Carriscar1/Iasis-app/hardware/cad/saida/previas/trava_paleta.png

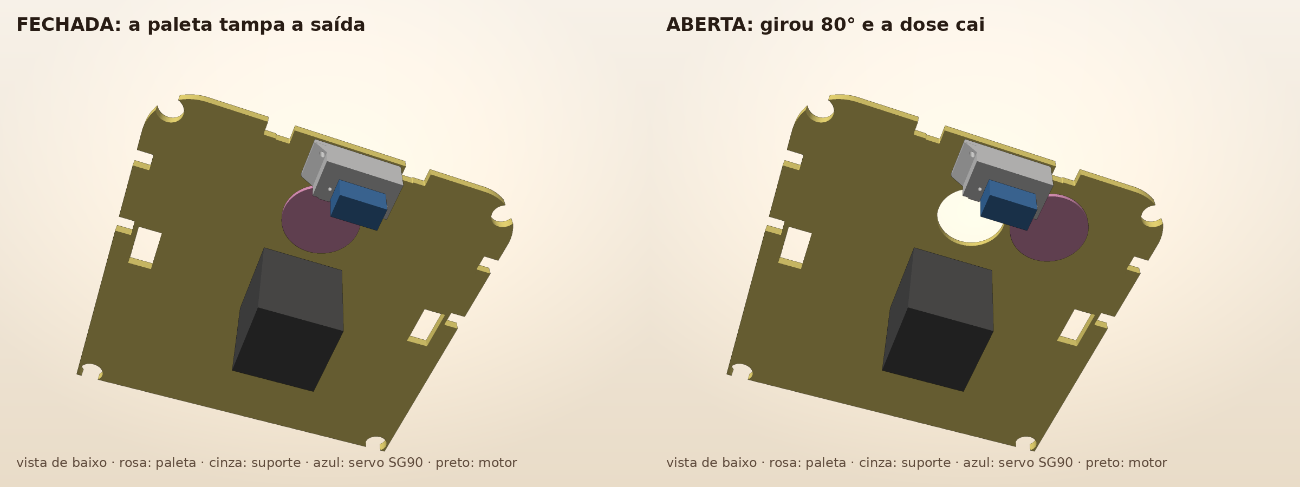
hardware/cad/saida/previas/trava_paleta.png
