Carriscar1/Iasis-app/hardware/cad/saida/previas/trava_calha.png

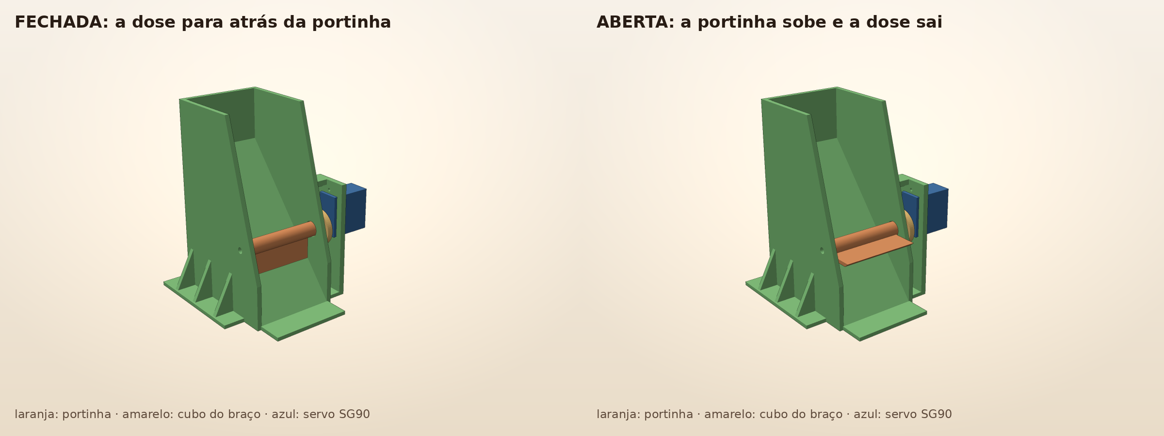
hardware/cad/saida/previas/trava_calha.png
