Carriscar1/Iasis-app/site/public/images/README.md

# 📸 Fotos do produto

Coloque aqui as fotos reais do seu dispenser IASIS. Assim que os arquivos
existirem, o site **troca automaticamente** a ilustração vetorial pela sua foto.

## Nomes dos arquivos (use exatamente estes)

| Arquivo | Onde aparece | Sugestão de foto |
|---|---|---|
| `dispenser.jpg` | Imagem principal (topo da home) | O dispenser inteiro, de frente, fundo claro |
| `detalhe-rfid.jpg` | Galeria "por dentro" | Close do leitor RFID / pulseira sendo aproximada |
| `detalhe-compartimentos.jpg` | Galeria "por dentro" | Close dos compartimentos com comprimidos |
| `detalhe-pulseira.jpg` | Galeria "por dentro" | A pulseira RFID no pulso |

> Aceita `.jpg`, `.jpeg`, `.png`, `.webp` ou `.avif`. Ex: pode ser `dispenser.png`.

## Dicas para a foto ficar profissional

- **Fundo claro e limpo** (uma parede branca ou uma folha grande de papel branco).
- **Boa luz** — de preferência luz natural, perto de uma janela, sem flash direto.
- Enquadre o produto **centralizado**, com um pouco de espaço em volta.
- Proporção ideal da foto principal: parecida com um quadrado ou retrato (ex: 1200×1400).
- As fotos de detalhe ficam melhores em paisagem 4:3 (ex: 1200×900).

Depois de colocar os arquivos aqui, recarregue o site — pronto.
