Carriscar1/Iasis-app/hardware/cad/saida/chaveiro/chaveiro.png

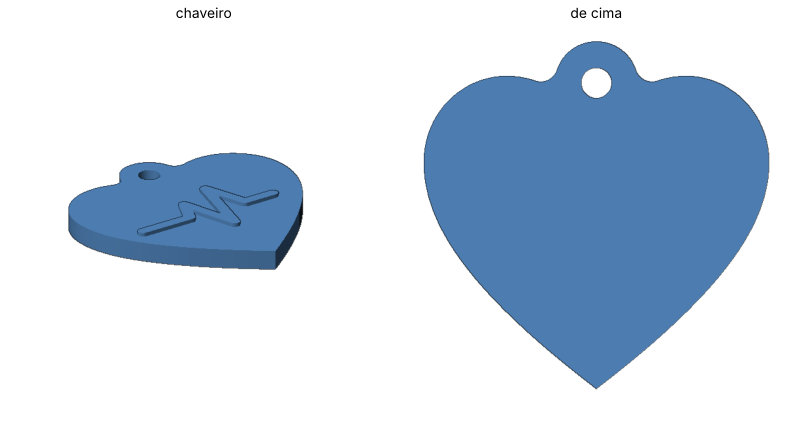
hardware/cad/saida/chaveiro/chaveiro.png
