Carriscar1/Iasis-app/hardware/cad/saida/previas/cortes_encaixes.png

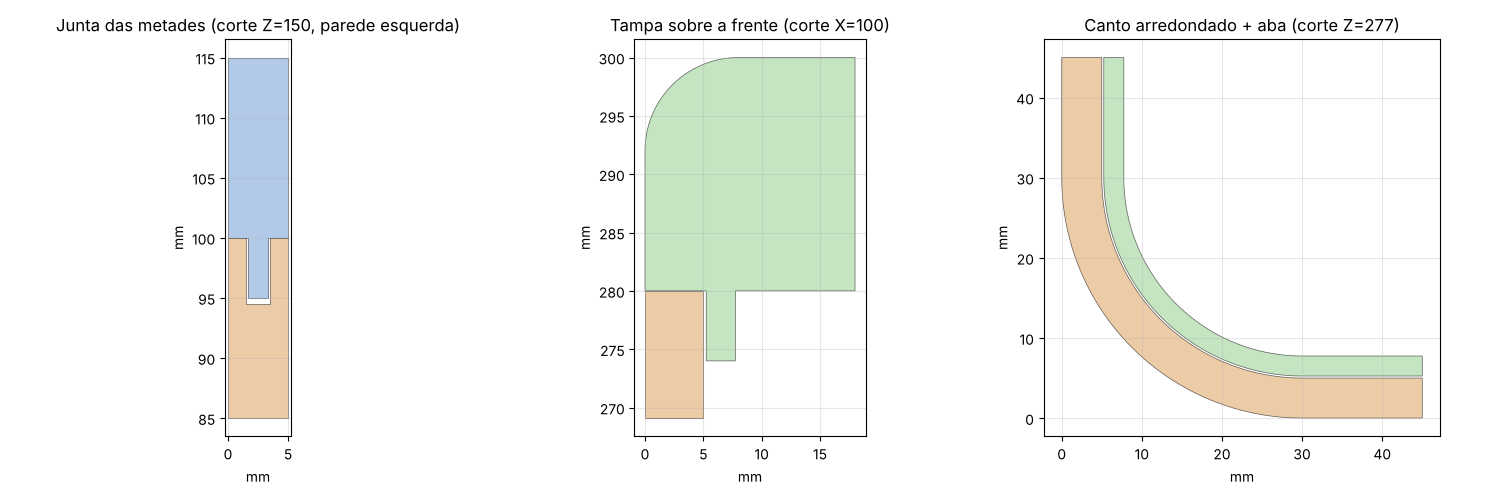
hardware/cad/saida/previas/cortes_encaixes.png
