Carriscar1/Iasis-app/hardware/cad/saida/previas/cortes_folgas.png

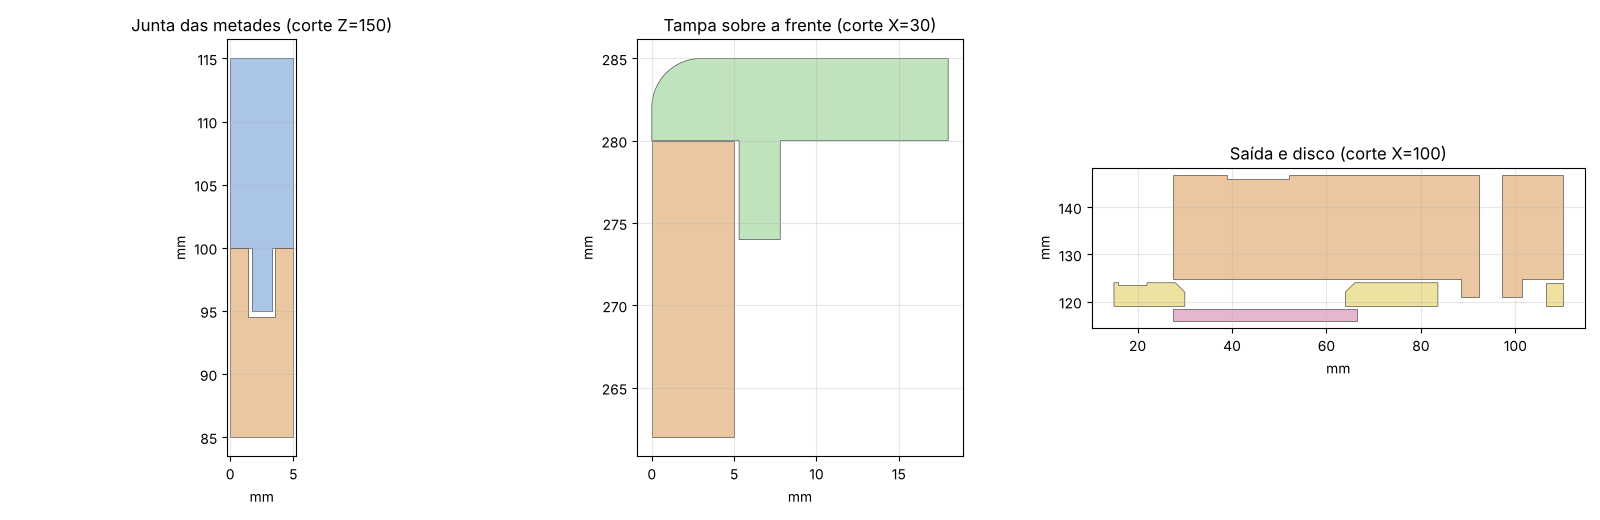
hardware/cad/saida/previas/cortes_folgas.png
