Carriscar1/Iasis-app/hardware/cad/saida/previas/explodida.png

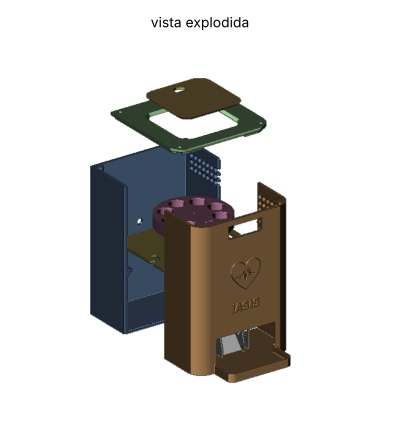
hardware/cad/saida/previas/explodida.png
