Carriscar1/Iasis-app/hardware/cad/saida/previas/frente_junta.png

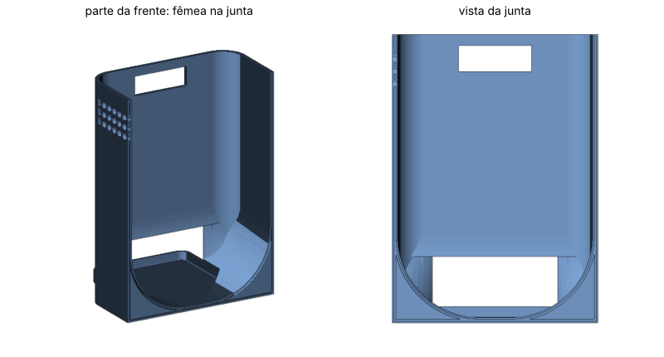
hardware/cad/saida/previas/frente_junta.png
