Carriscar1/Iasis-app/hardware/cad/saida/previas/interior.png

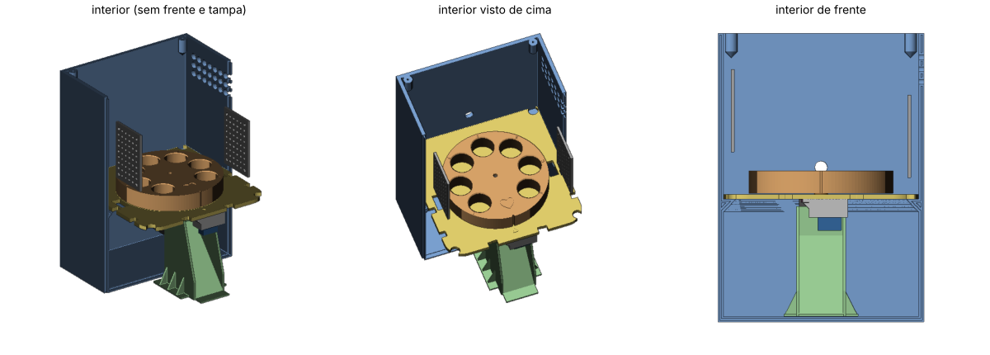
hardware/cad/saida/previas/interior.png
