Carriscar1/Iasis-app/hardware/cad/saida/previas/mecanismo.png

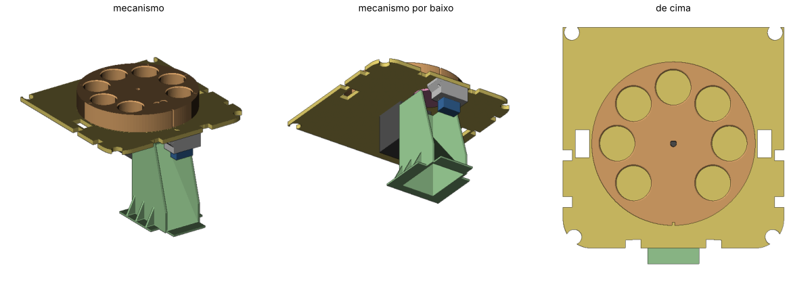
hardware/cad/saida/previas/mecanismo.png
