Carriscar1/Iasis-app/hardware/cad/saida/previas/tampa_aba.png

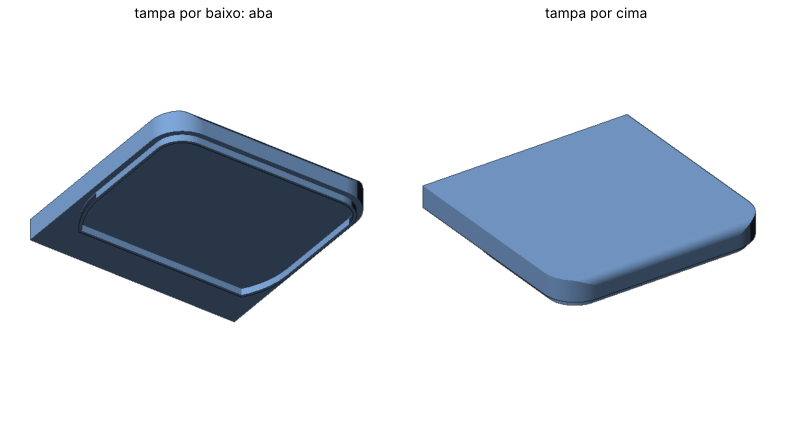
hardware/cad/saida/previas/tampa_aba.png
