Carriscar1/Iasis-app/hardware/cad/saida/previas/tras_junta.png

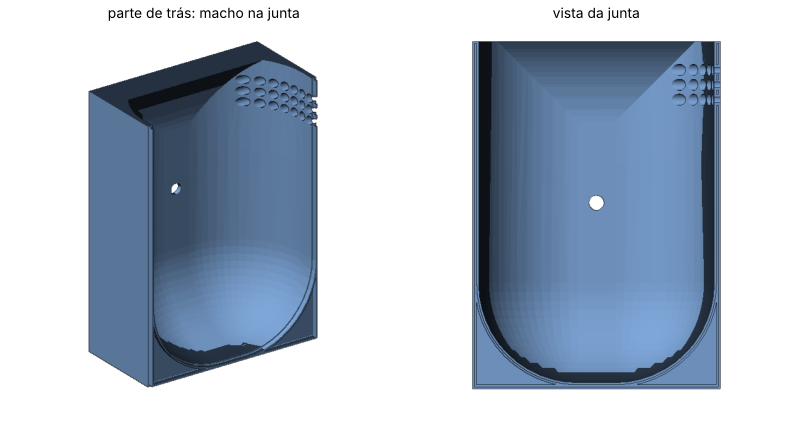
hardware/cad/saida/previas/tras_junta.png
