Carriscar1/Iasis-app/hardware/cad/saida/previas/versao_dividida.png

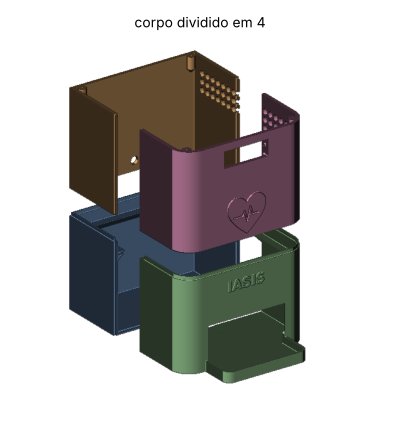
hardware/cad/saida/previas/versao_dividida.png
