Carriscar1/Iasis-app/hardware/cad/originais/peca2_parte_da_frente.stl

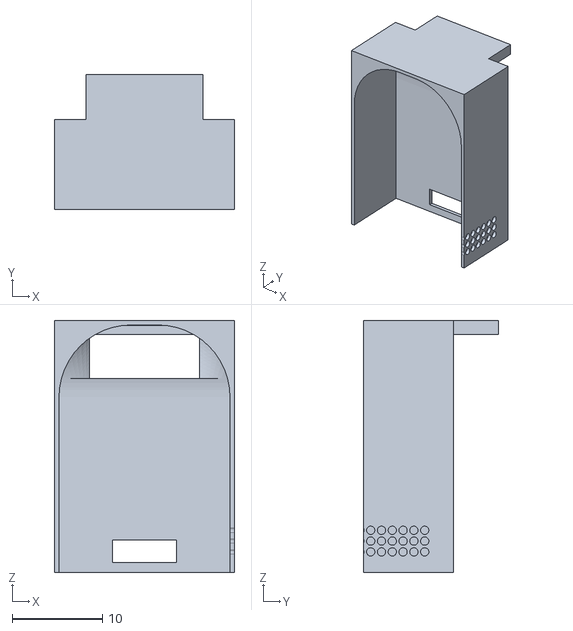
[picture p13: CAD file, 2026-10-19]
hardware/cad/originais/peca2_parte_da_frente.stl
20.0 x 15.0 x 28.0
