Carriscar1/Iasis-app/hardware/cad/saida/chaveiro/chaveiro_base.stl

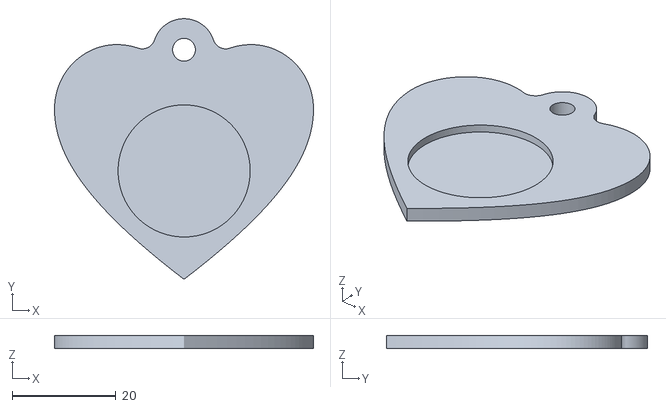
[picture p14: CAD file, 2026-11-05]
hardware/cad/saida/chaveiro/chaveiro_base.stl
50.0 x 50.3 x 2.60
