Carriscar1/Iasis-app/hardware/cad/saida/corpo_de_prova/2_tampa_canto.stl

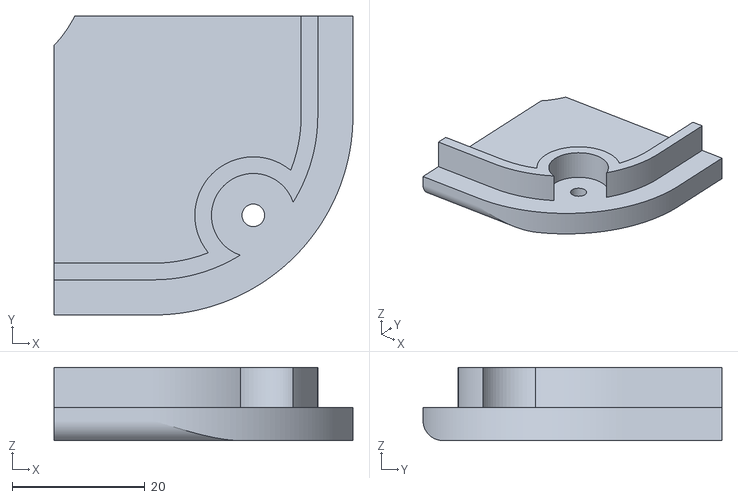
[picture p15: CAD file, 2026-10-21]
hardware/cad/saida/corpo_de_prova/2_tampa_canto.stl
45.0 x 45.0 x 11.0
