Carriscar1/Iasis-app/hardware/cad/saida/imprimir_dividido/gabarito_trava.stl

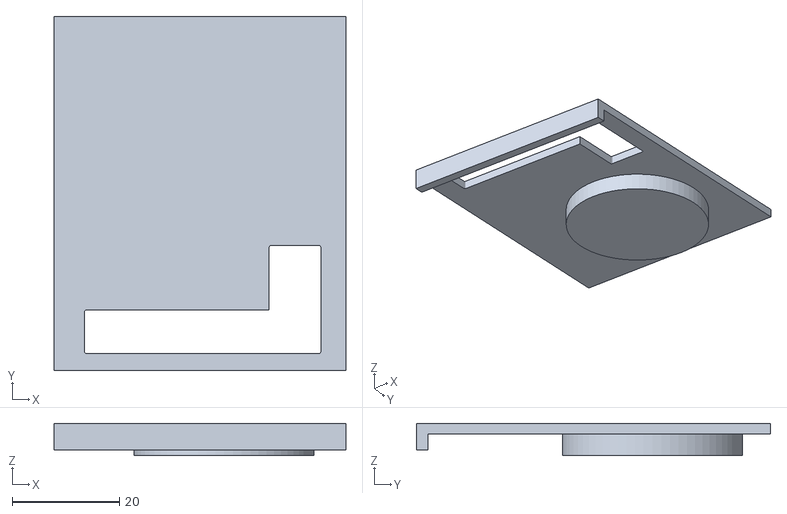
[picture p16: CAD file, 2026-11-10]
hardware/cad/saida/imprimir_dividido/gabarito_trava.stl
54.4 x 66.0 x 6.00
