Carriscar1/Iasis-app/hardware/cad/saida/imprimir_inteiro/paleta.stl

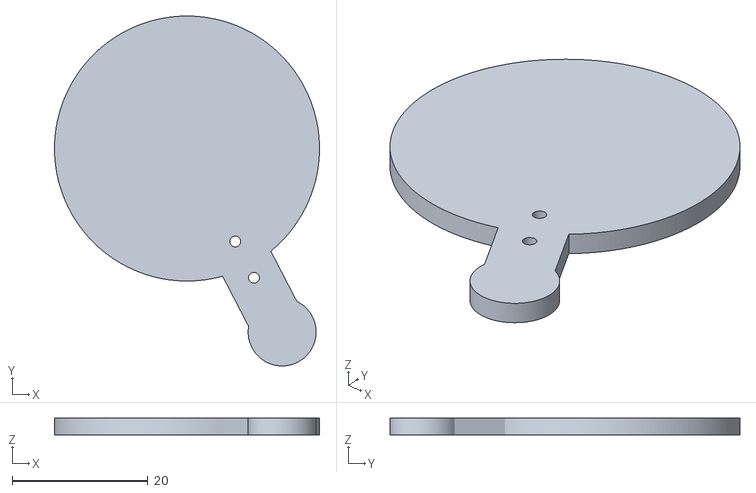
[picture p17: CAD file, 2026-11-10]
hardware/cad/saida/imprimir_inteiro/paleta.stl
39.0 x 51.5 x 2.50
