Carriscar1/Iasis-app/hardware/cad/saida/montagem/suporte_servo.stl

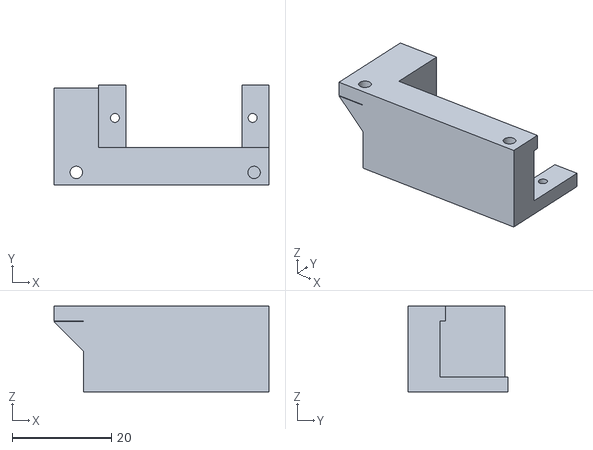
[picture p18: CAD file, 2026-11-10]
hardware/cad/saida/montagem/suporte_servo.stl
43.4 x 20.1 x 17.3
