Carriscar1/Iasis-app/hardware/cad/originais/peca_do_teto.stl

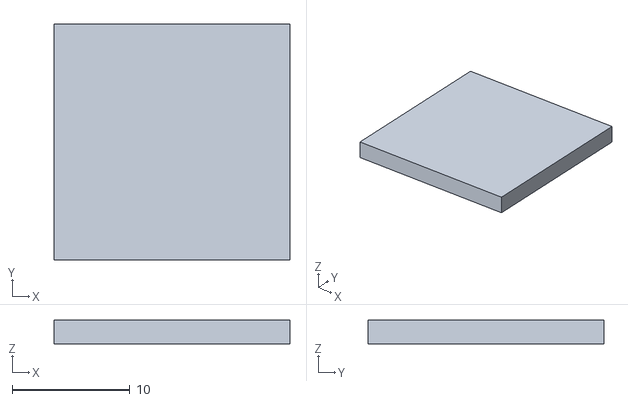
[picture p19: CAD file, 2026-10-19]
hardware/cad/originais/peca_do_teto.stl
20.0 x 20.0 x 2.00
