Carriscar1/Iasis-app/hardware/cad/saida/chaveiro/chaveiro_tampa.stl

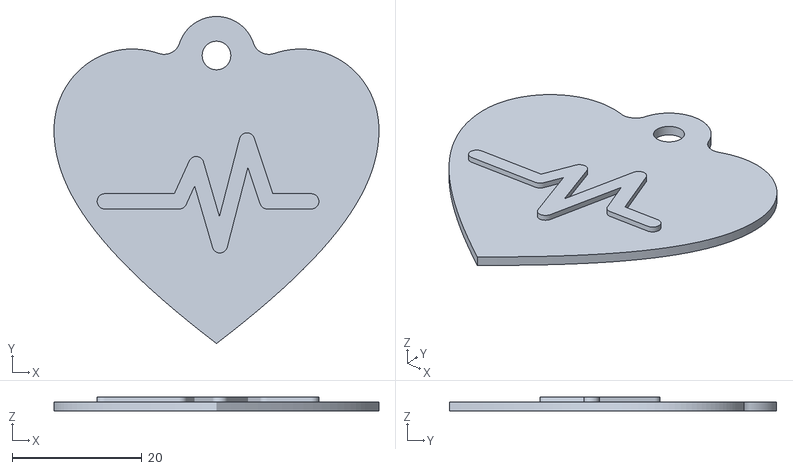
[picture p20: CAD file, 2026-11-05]
hardware/cad/saida/chaveiro/chaveiro_tampa.stl
50.0 x 50.3 x 2.20
