Carriscar1/Iasis-app/hardware/cad/saida/corpo_de_prova/4_disco_centro_no_eixo.stl

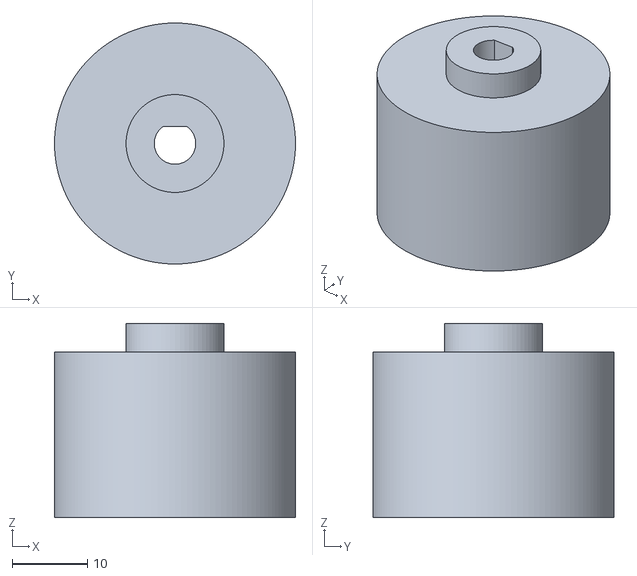
[picture p21: CAD file, 2026-10-21]
hardware/cad/saida/corpo_de_prova/4_disco_centro_no_eixo.stl
32.0 x 32.0 x 25.8
