Carriscar1/Iasis-app/hardware/cad/saida/imprimir_dividido/disco.stl

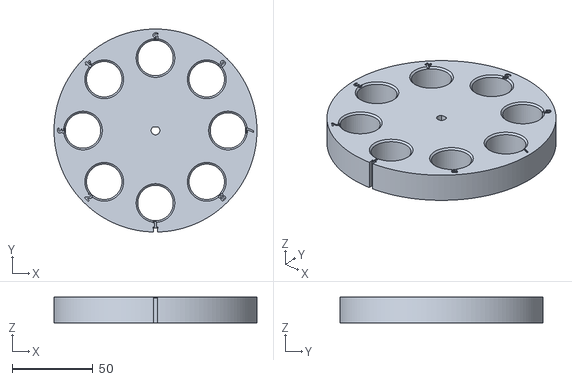
[picture p22: CAD file, 2026-10-20]
hardware/cad/saida/imprimir_dividido/disco.stl
126.0 x 126.0 x 16.0
