Carriscar1/Iasis-app/hardware/cad/saida/montagem/calha.stl

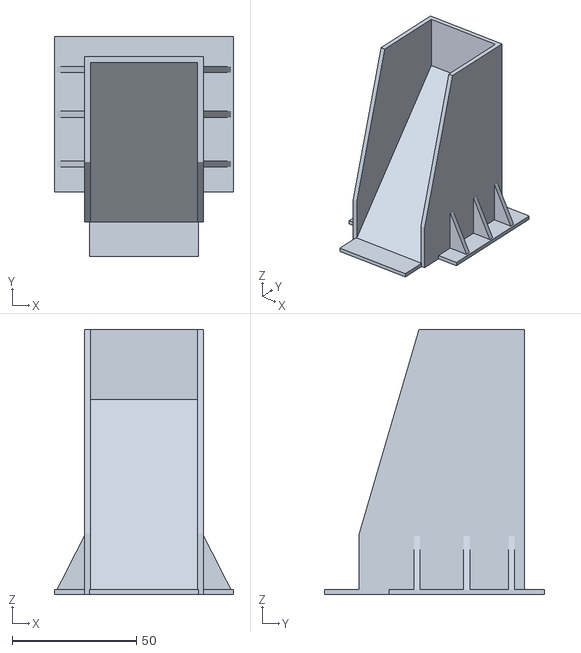
[picture p23: CAD file, 2026-11-10]
hardware/cad/saida/montagem/calha.stl
72.0 x 88.5 x 106.5
