Carriscar1/Iasis-app/hardware/cad/originais/peca1_parte_de_tras.stl

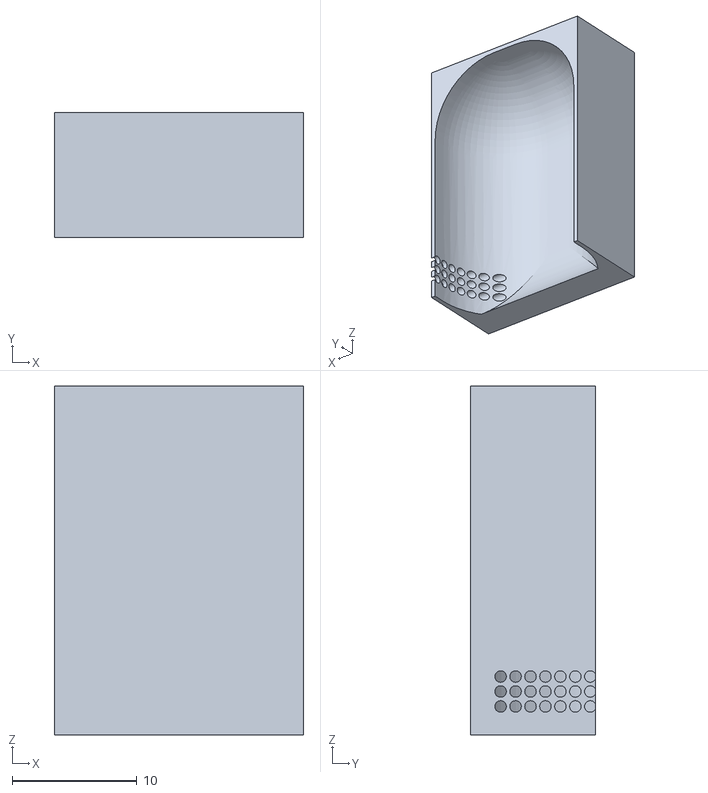
[picture p24: CAD file, 2026-10-19]
hardware/cad/originais/peca1_parte_de_tras.stl
20.0 x 10.0 x 28.0
