Carriscar1/Iasis-app/hardware/cad/saida/chaveiro/chaveiro_com_pausa.stl

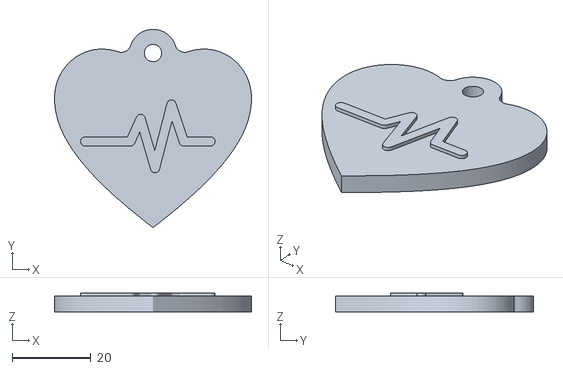
[picture p25: CAD file, 2026-11-05]
hardware/cad/saida/chaveiro/chaveiro_com_pausa.stl
50.0 x 50.3 x 4.80
