Carriscar1/Iasis-app/hardware/cad/saida/corpo_de_prova/5_tampa_portinha_canto.stl

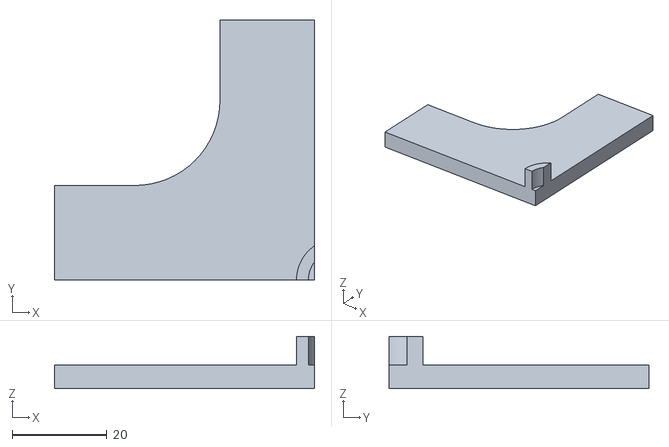
[picture p26: CAD file, 2026-10-21]
hardware/cad/saida/corpo_de_prova/5_tampa_portinha_canto.stl
55.0 x 55.0 x 11.0
