Carriscar1/Iasis-app/hardware/cad/saida/imprimir_dividido/corpo_tras_baixo.stl

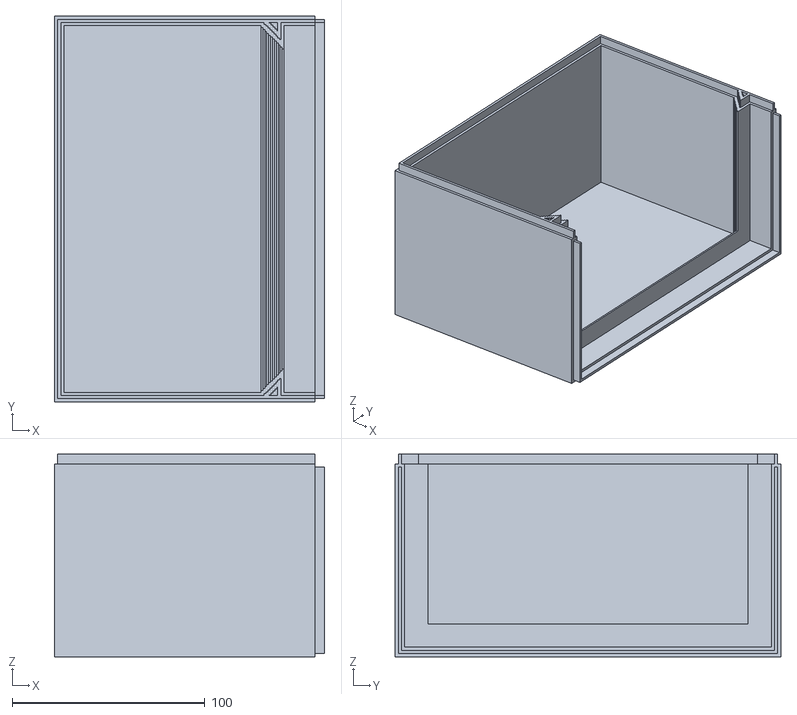
[picture p27: CAD file, 2026-10-20]
hardware/cad/saida/imprimir_dividido/corpo_tras_baixo.stl
140.0 x 200.0 x 105.0
