Carriscar1/Iasis-app/hardware/cad/saida/imprimir_inteiro/cubo_trava.stl

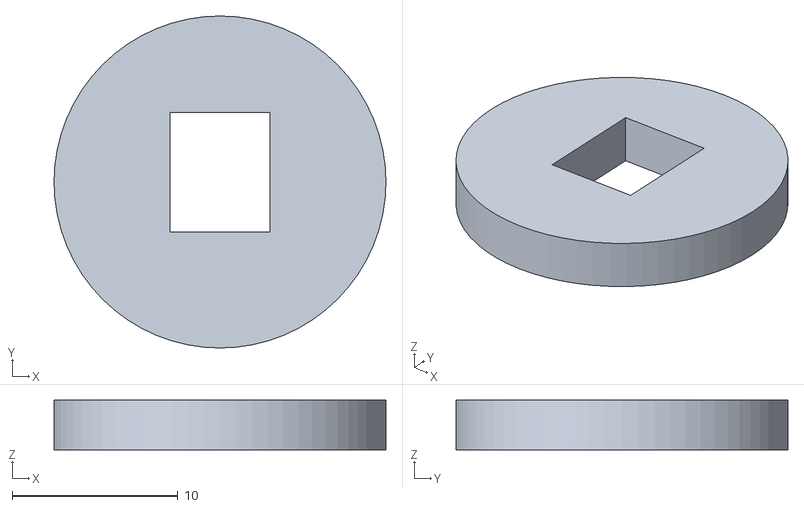
[picture p28: CAD file, 2026-11-05]
hardware/cad/saida/imprimir_inteiro/cubo_trava.stl
20.0 x 20.0 x 3.00
