Carriscar1/Iasis-app/hardware/cad/saida/corpo_de_prova/5_portinha_canto.stl

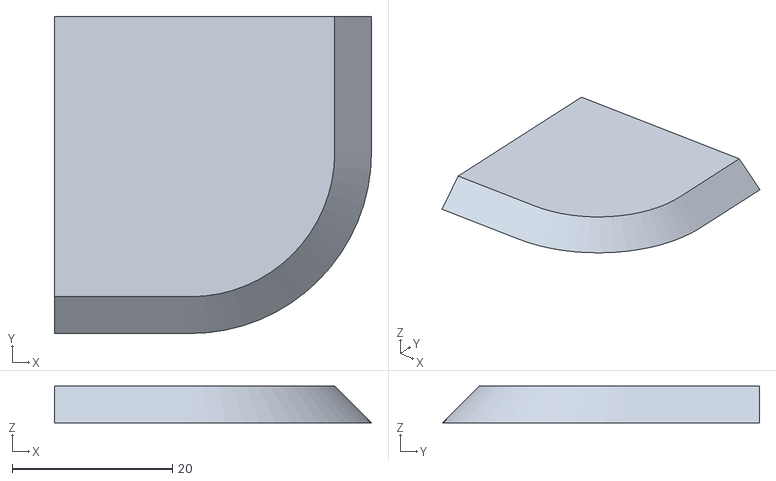
[picture p29: CAD file, 2026-10-21]
hardware/cad/saida/corpo_de_prova/5_portinha_canto.stl
39.6 x 39.6 x 4.60
