Carriscar1/Iasis-app/hardware/cad/saida/imprimir_dividido/corpo_frente_baixo.stl

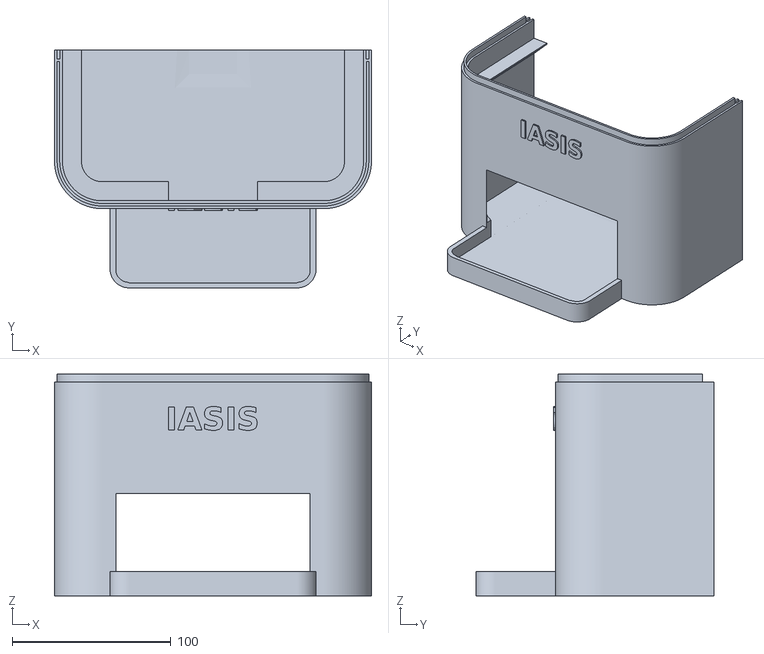
[picture p30: CAD file, 2026-10-20]
hardware/cad/saida/imprimir_dividido/corpo_frente_baixo.stl
200.0 x 150.0 x 140.0
