Carriscar1/Iasis-app/hardware/cad/saida/imprimir_inteiro/calha.stl

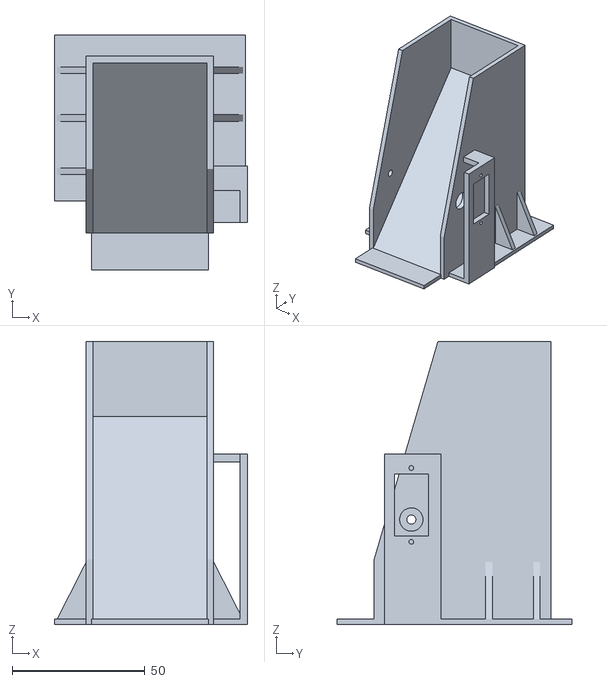
[picture p31: CAD file, 2026-11-05]
hardware/cad/saida/imprimir_inteiro/calha.stl
72.8 x 88.5 x 106.5
