Carriscar1/Iasis-app/hardware/cad/saida/corpo_de_prova/3_divisao_cima.stl

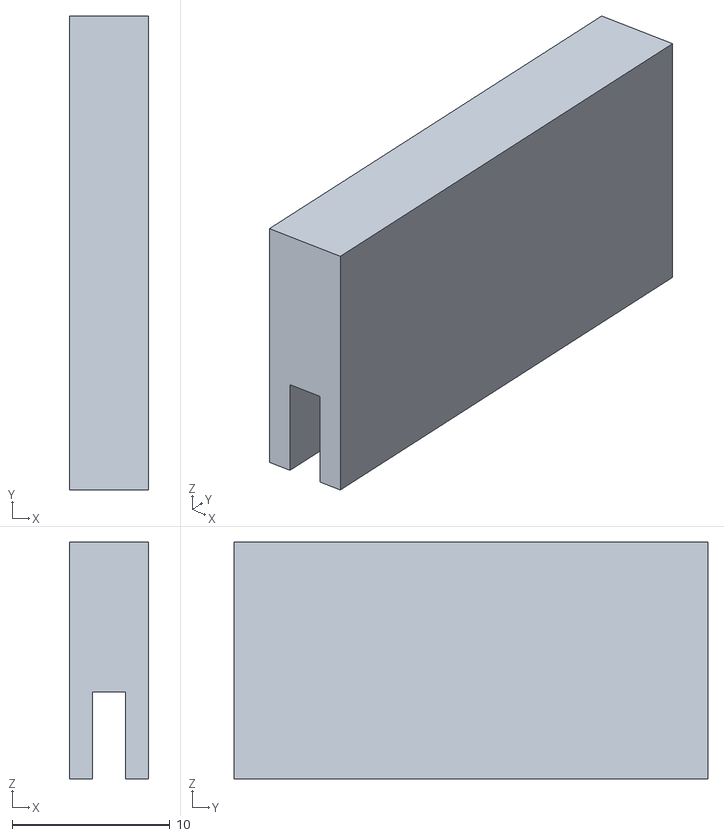
[picture p32: CAD file, 2026-10-20]
hardware/cad/saida/corpo_de_prova/3_divisao_cima.stl
5.00 x 30.0 x 15.0
