Carriscar1/Iasis-app/hardware/cad/saida/imprimir_dividido/corpo_tras_cima.stl

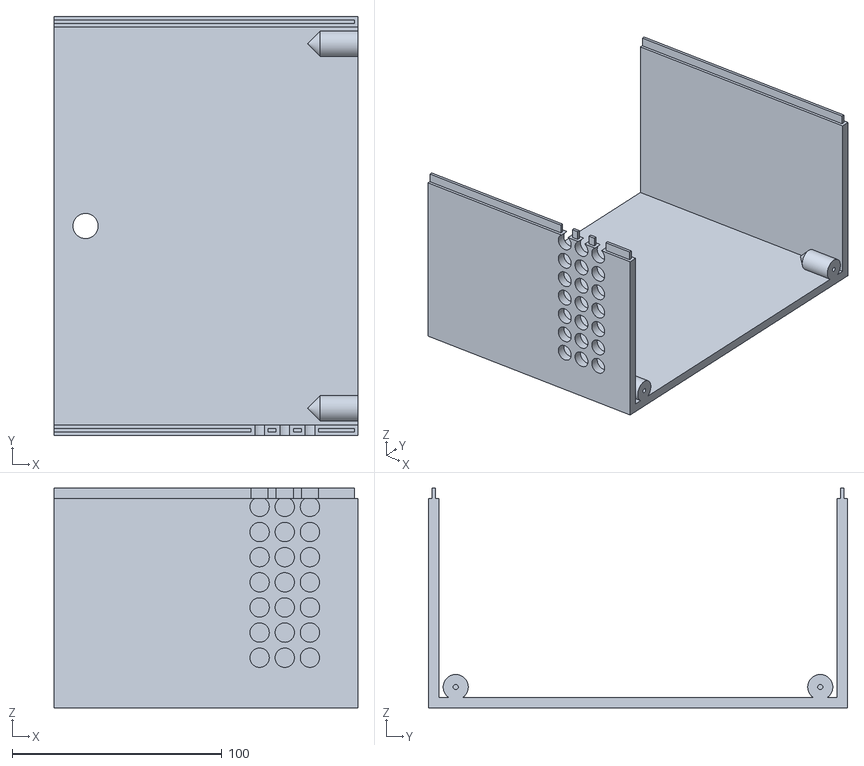
[picture p33: CAD file, 2026-10-20]
hardware/cad/saida/imprimir_dividido/corpo_tras_cima.stl
145.0 x 200.0 x 105.0
