Carriscar1/Iasis-app/hardware/cad/saida/imprimir_inteiro/porta_trava.stl

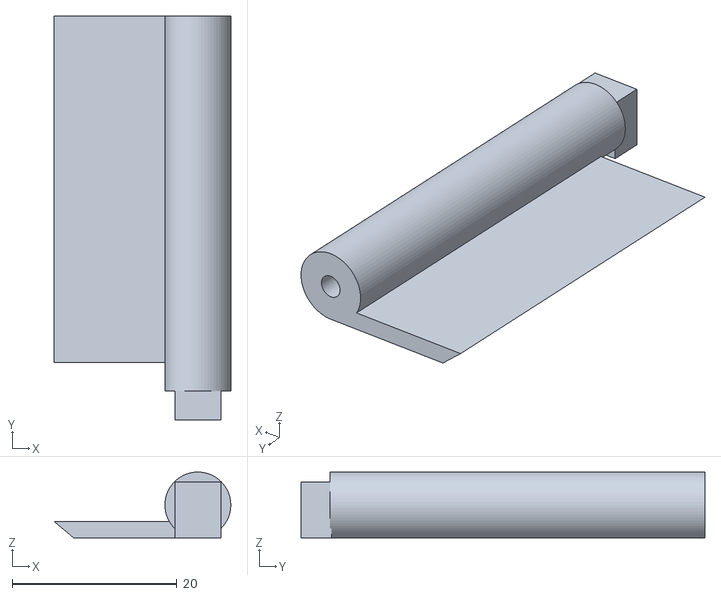
[picture p34: CAD file, 2026-11-05]
hardware/cad/saida/imprimir_inteiro/porta_trava.stl
21.4 x 49.0 x 8.00
