Carriscar1/Iasis-app/hardware/cad/saida/corpo_de_prova/1_junta_parte_da_frente.stl

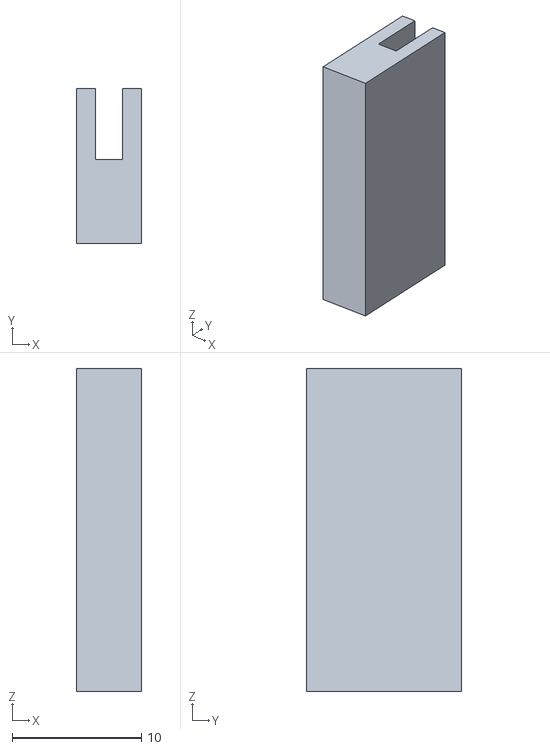
[picture p35: CAD file, 2026-10-20]
hardware/cad/saida/corpo_de_prova/1_junta_parte_da_frente.stl
5.00 x 12.0 x 25.0
