Carriscar1/Iasis-app/hardware/cad/saida/imprimir_dividido/tampa.stl

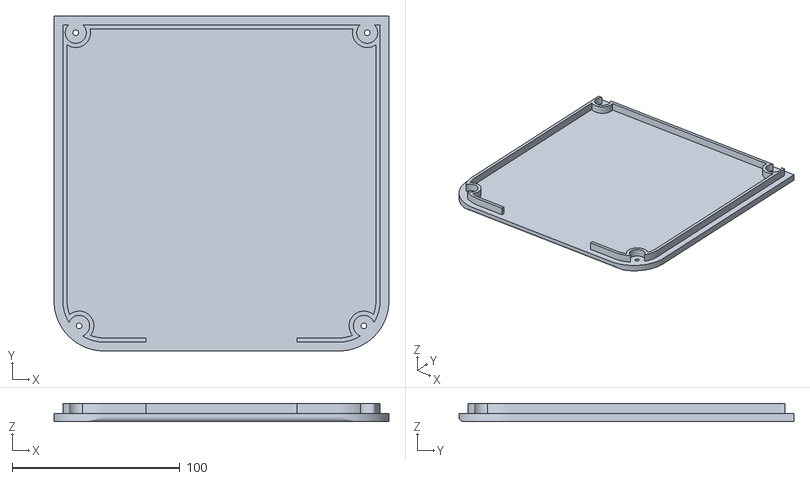
[picture p36: CAD file, 2026-10-20]
hardware/cad/saida/imprimir_dividido/tampa.stl
200.0 x 200.0 x 11.0
