Carriscar1/Iasis-app/hardware/cad/saida/imprimir_inteiro/prateleira.stl

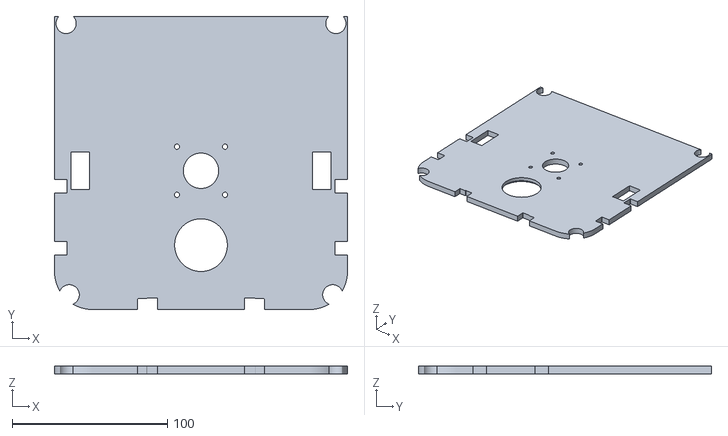
[picture p37: CAD file, 2026-10-21]
hardware/cad/saida/imprimir_inteiro/prateleira.stl
189.0 x 189.0 x 5.00
