Carriscar1/Iasis-app/hardware/cad/saida/corpo_de_prova/3_divisao_baixo.stl

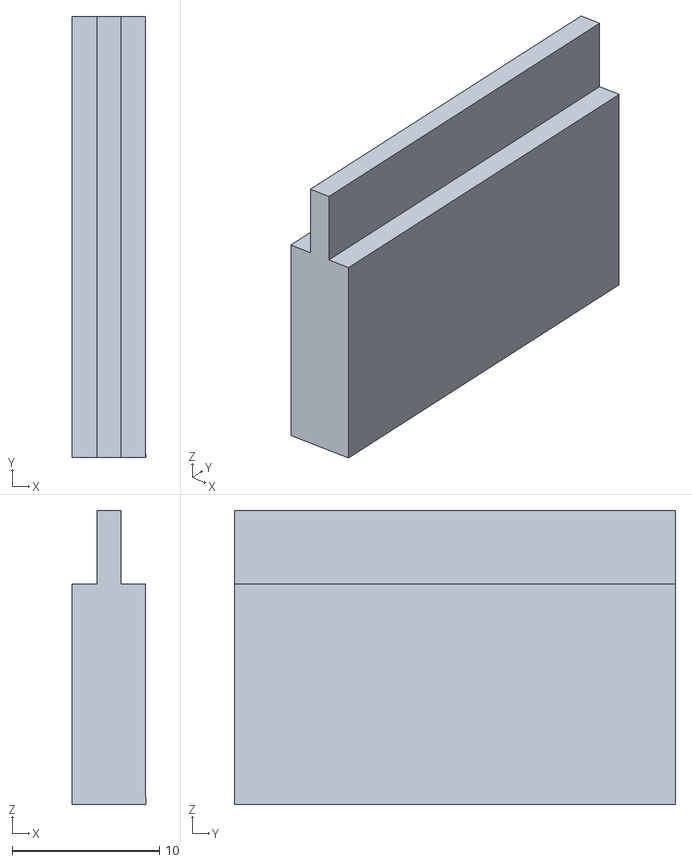
[picture p38: CAD file, 2026-10-20]
hardware/cad/saida/corpo_de_prova/3_divisao_baixo.stl
5.00 x 30.0 x 20.0
