Carriscar1/Iasis-app/hardware/cad/saida/imprimir_dividido/corpo_frente_cima.stl

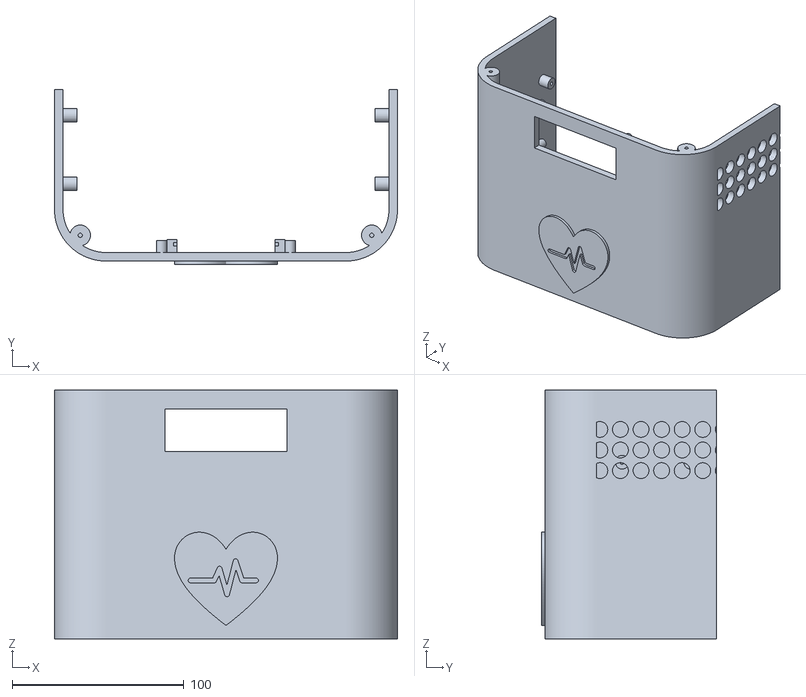
[picture p39: CAD file, 2026-10-20]
hardware/cad/saida/imprimir_dividido/corpo_frente_cima.stl
200.0 x 102.0 x 145.0
