Carriscar1/Iasis-app/hardware/cad/saida/imprimir_inteiro/tampa.stl

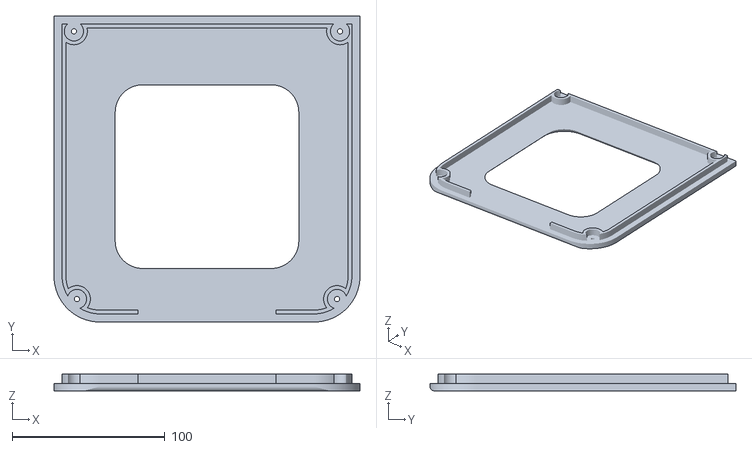
[picture p40: CAD file, 2026-10-21]
hardware/cad/saida/imprimir_inteiro/tampa.stl
200.0 x 200.0 x 11.0
