Carriscar1/Iasis-app/hardware/cad/saida/corpo_de_prova/1_junta_parte_de_tras.stl

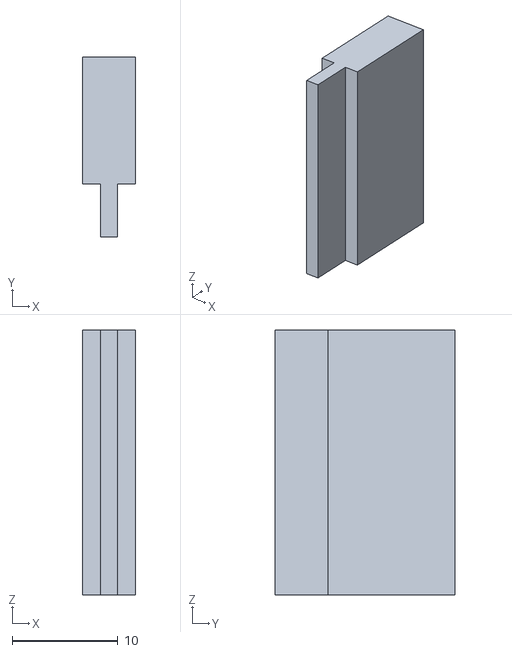
[picture p41: CAD file, 2026-10-20]
hardware/cad/saida/corpo_de_prova/1_junta_parte_de_tras.stl
5.00 x 17.0 x 25.0
