Carriscar1/Iasis-app/hardware/cad/saida/imprimir_dividido/prateleira.stl

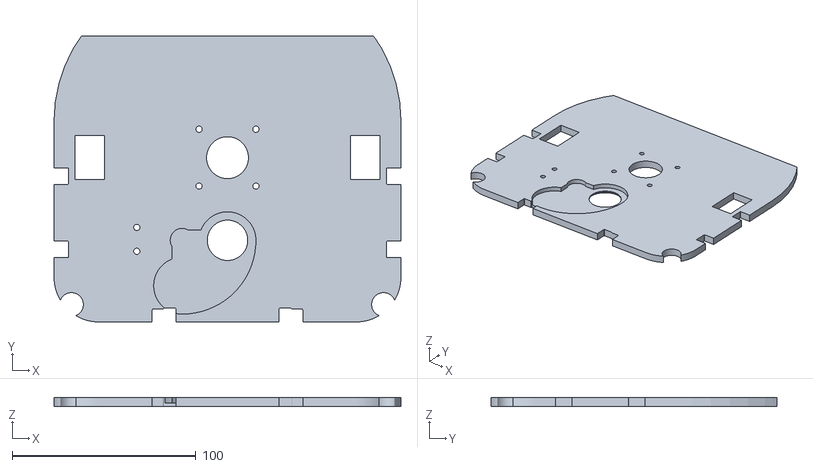
[picture p42: CAD file, 2026-10-20]
hardware/cad/saida/imprimir_dividido/prateleira.stl
189.0 x 155.8 x 5.00
