Carriscar1/Iasis-app/hardware/cad/saida/imprimir_inteiro/disco.stl

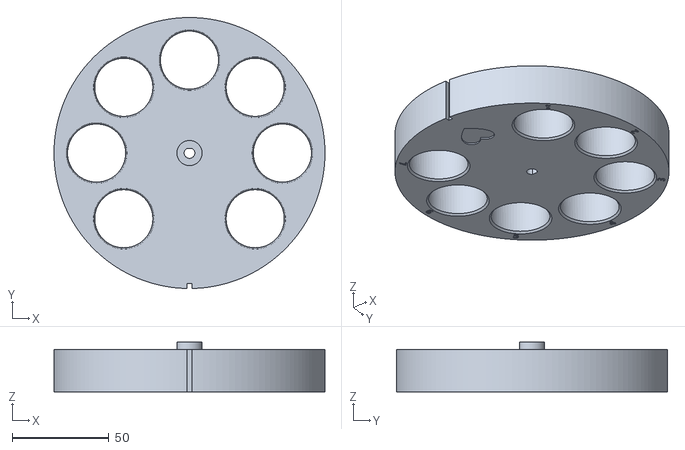
[picture p43: CAD file, 2026-10-21]
hardware/cad/saida/imprimir_inteiro/disco.stl
140.0 x 140.0 x 25.8
