Carriscar1/Iasis-app/hardware/cad/saida/corpo_de_prova/2_corpo_canto_topo.stl

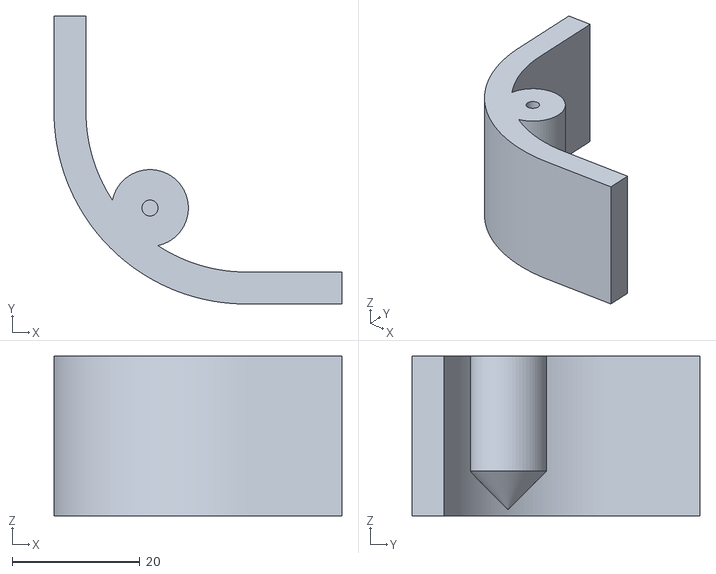
[picture p44: CAD file, 2026-10-20]
hardware/cad/saida/corpo_de_prova/2_corpo_canto_topo.stl
45.0 x 45.0 x 25.0
