Carriscar1/Iasis-app/hardware/cad/saida/imprimir_dividido/calha.stl

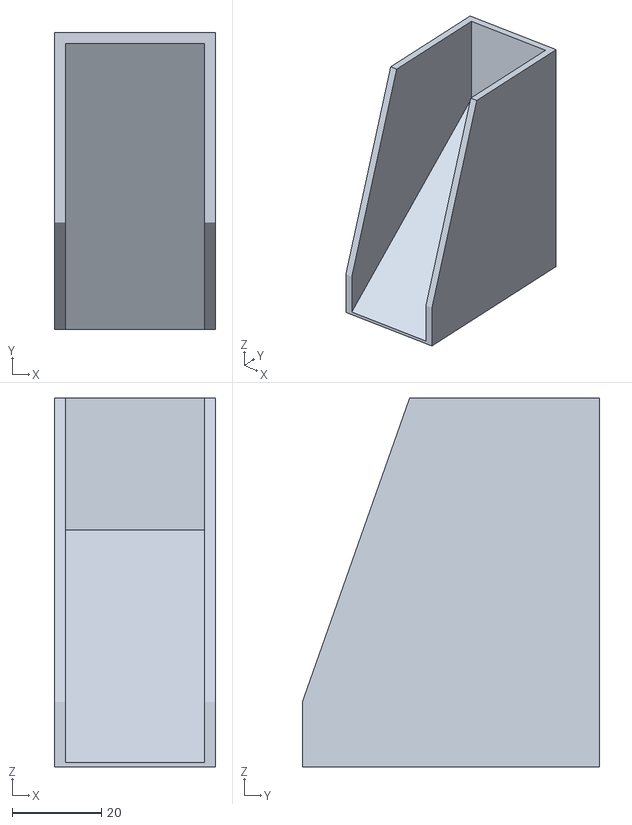
[picture p45: CAD file, 2026-10-20]
hardware/cad/saida/imprimir_dividido/calha.stl
36.0 x 66.5 x 82.5
