Carriscar1/Iasis-app/hardware/cad/saida/imprimir_inteiro/portinha.stl

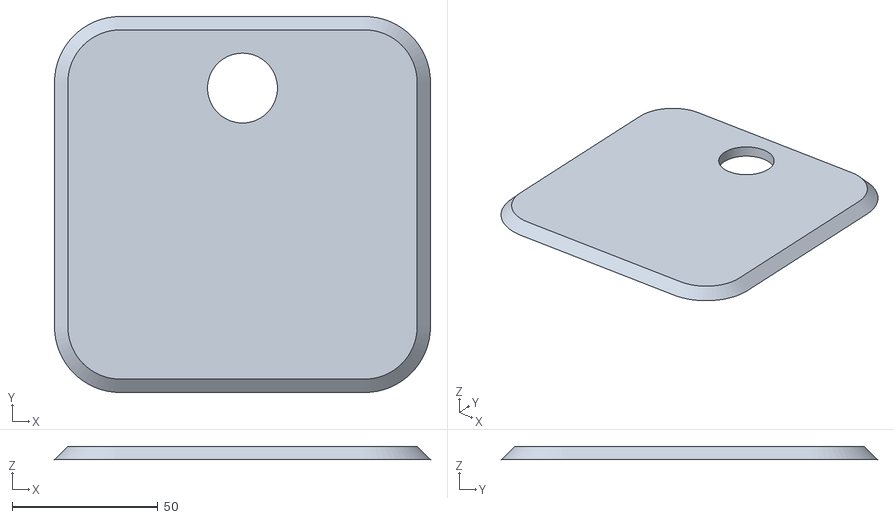
[picture p46: CAD file, 2026-10-21]
hardware/cad/saida/imprimir_inteiro/portinha.stl
129.2 x 129.2 x 4.60
