Carriscar1/Iasis-app/hardware/cad/saida/corpo_de_prova/5_suporte_servo.stl

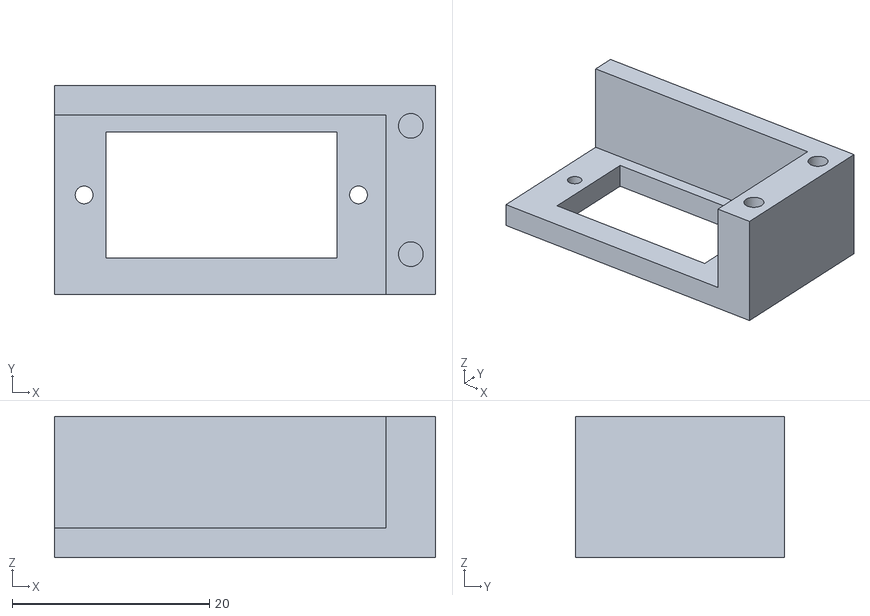
[picture p47: CAD file, 2026-10-20]
hardware/cad/saida/corpo_de_prova/5_suporte_servo.stl
38.6 x 21.2 x 14.3
