Carriscar1/Iasis-app/hardware/cad/saida/imprimir_dividido/paleta.stl

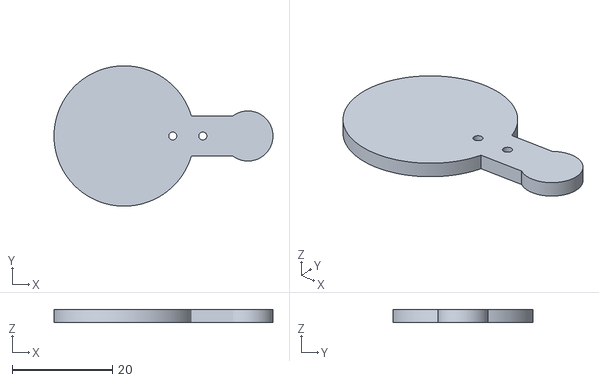
[picture p48: CAD file, 2026-10-20]
hardware/cad/saida/imprimir_dividido/paleta.stl
43.7 x 28.0 x 2.50
