Carriscar1/Iasis-app/hardware/cad/saida/imprimir_inteiro/corpo_parte_de_tras.stl

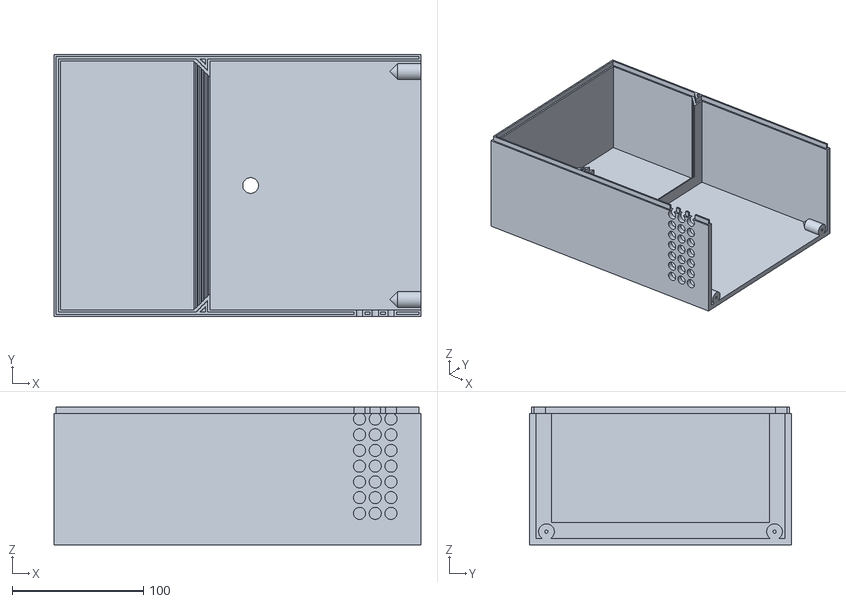
[picture p49: CAD file, 2026-10-20]
hardware/cad/saida/imprimir_inteiro/corpo_parte_de_tras.stl
280.0 x 200.0 x 105.0
