Carriscar1/Iasis-app/hardware/cad/saida/imprimir_inteiro/corpo_parte_da_frente.stl

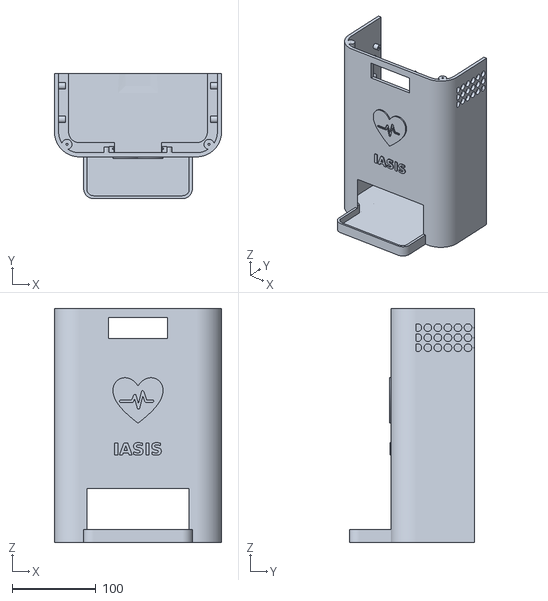
[picture p50: CAD file, 2026-10-20]
hardware/cad/saida/imprimir_inteiro/corpo_parte_da_frente.stl
200.0 x 150.0 x 280.0
