Carriscar1/Iasis-app/hardware/cad/saida/imprimir_inteiro/painel_eletronica_x2.stl

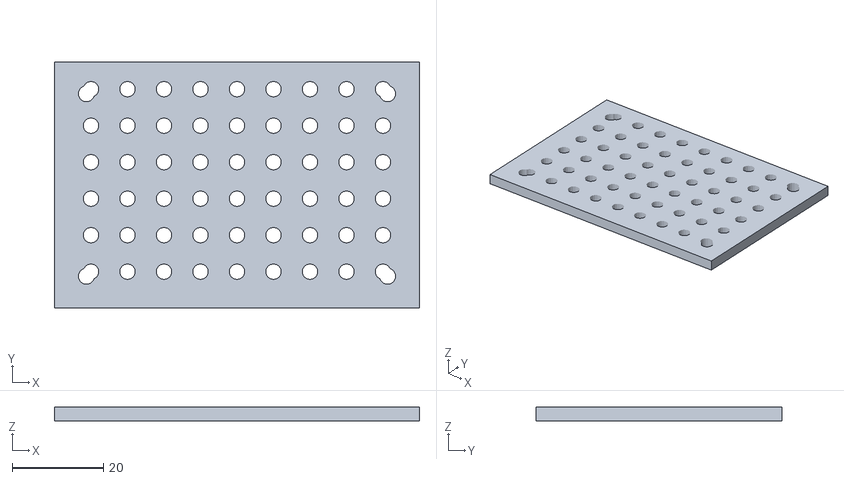
[picture p51: CAD file, 2026-10-20]
hardware/cad/saida/imprimir_inteiro/painel_eletronica_x2.stl
80.0 x 54.0 x 3.00
