Carriscar1/Iasis-app/(list of files, cad)

Other CAD files:
hardware/cad/saida/imprimir_inteiro/suporte_servo.stl
hardware/cad/saida/montagem/paleta.stl
hardware/cad/saida/montagem/gabarito_trava.stl
hardware/cad/saida/montagem/porta_trava.stl
hardware/cad/saida/montagem/cubo_trava.stl
hardware/cad/saida/montagem/tampa.stl
hardware/cad/saida/montagem/prateleira.stl
hardware/cad/saida/montagem/portinha.stl
hardware/cad/saida/montagem/disco.stl
hardware/cad/saida/montagem/corpo_parte_de_tras.stl
hardware/cad/saida/montagem/corpo_parte_da_frente.stl
hardware/cad/saida/montagem/painel_eletronica_esquerdo.stl
hardware/cad/saida/montagem/painel_eletronica_direito.stl
hardware/cad/saida/corpo_parte_da_frente.stl
hardware/cad/saida/corpo_parte_de_tras.stl
hardware/cad/saida/tampa.stl
