Carriscar1/Iasis-app/hardware/cad/saida/previas/guia_montagem.png

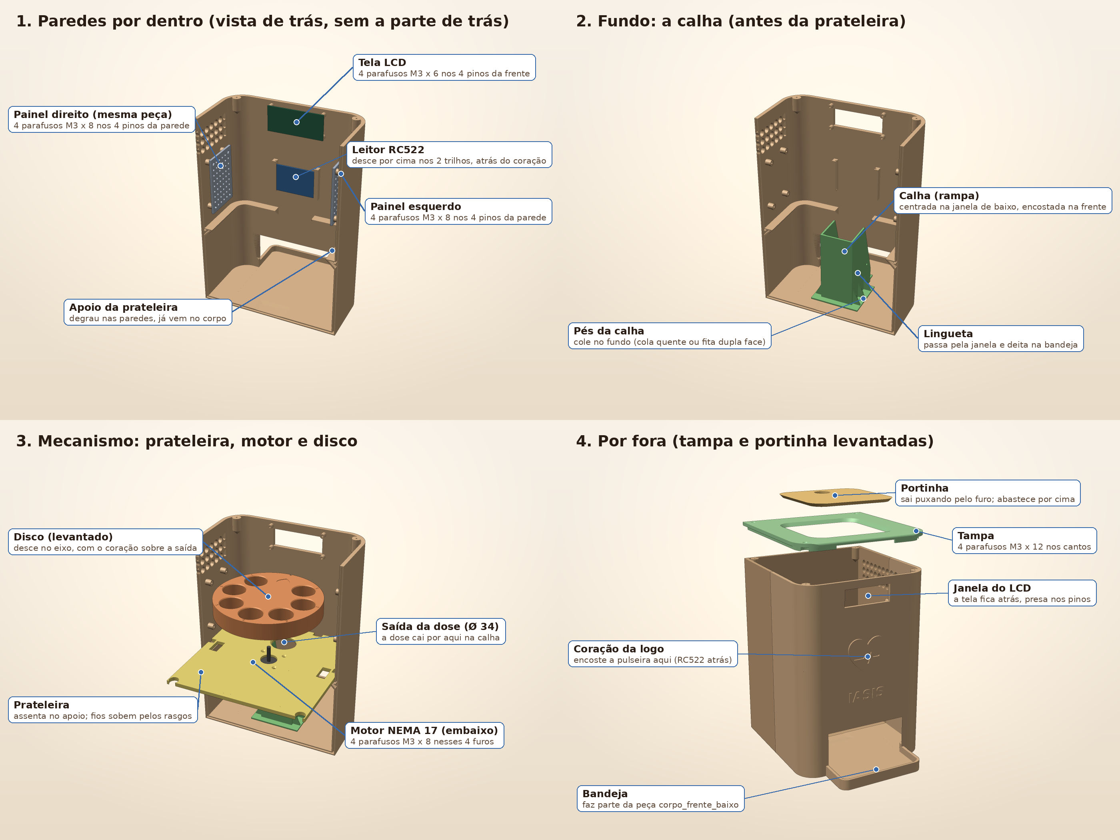
hardware/cad/saida/previas/guia_montagem.png
