Carriscar1/Iasis-app/hardware/cad/saida/previas/montagem.png

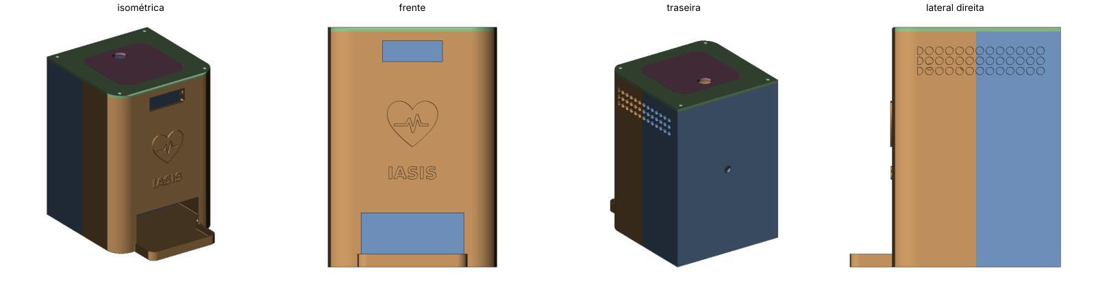
hardware/cad/saida/previas/montagem.png
