Carriscar1/Iasis-app/hardware/manual/diagrama_fiacao.png

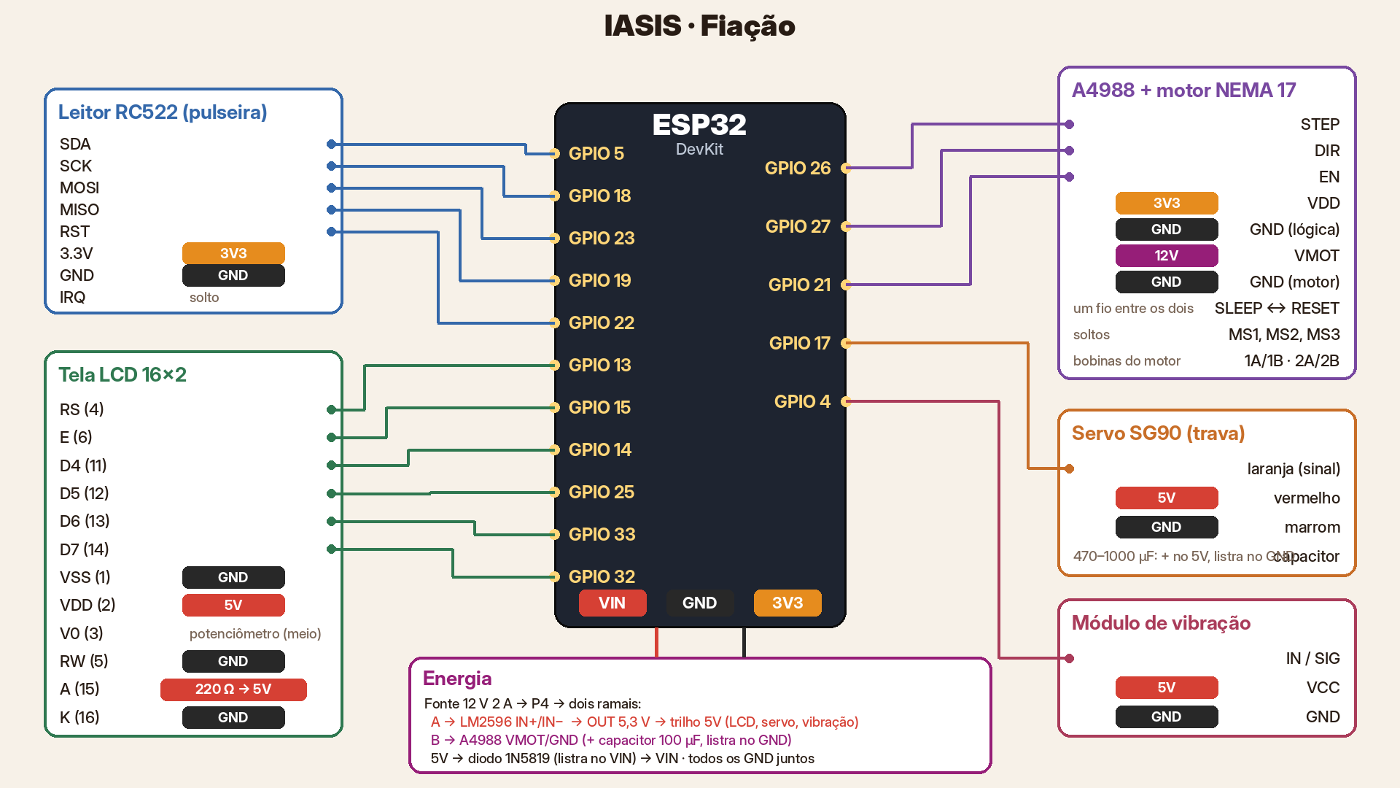
hardware/manual/diagrama_fiacao.png
