Carriscar1/Iasis-app/hardware/cad/dispenser.py

"""
IASIS — gera todas as peças do dispensador a partir dos STL originais.

    python hardware/cad/dispenser.py

Lê  hardware/cad/originais/*.stl  (cm, de cabeça para baixo)
Gera hardware/cad/saida/
       montagem/          peças no lugar em que ficam no dispensador (conferência)
       imprimir_inteiro/  tudo já deitado na posição de impressão (impressora ≥ 285 mm de altura)
       imprimir_dividido/ corpo cortado em 4 (impressora ≥ 210 × 210 × 150 mm)
       corpo_de_prova/    pedaços pequenos para testar folgas antes das peças grandes
       previas/           imagens de conferência

Referencial (mm): X = largura (0 esquerda → 200 direita, olhando a frente),
Y = profundidade (0 = face da frente, 200 = face de trás), Z = altura (0 = mesa).
Toda medida ajustável está em PARAMETROS. Nada é editado à mão nos STL.
"""
from __future__ import annotations

import math
import sys
from itertools import combinations
from pathlib import Path

import numpy as np
from shapely.geometry import Point, Polygon, box
from shapely.ops import unary_union

AQUI = Path(__file__).resolve().parent
sys.path.insert(0, str(AQUI.parents[1] / ".claude/skills/iasis-cad/scripts"))
import iasis_cad as cad   # noqa: E402
import render             # noqa: E402

PARAMETROS = dict(
    # ── Acabamento da carcaça ──────────────────────────────────────────────
    raio_frente=30.0, raio_tampa_frente=3.0, raio_bandeja=12.0,
    # Versão rápida: o enchimento maciço dos originais (bojo da frente e rampa de
    # trás) sai; a calha já leva o remédio até a bandeja. Por fora nada muda.
    esvaziar=True,
    tampa_espessura=5.0,          # era 20 mm maciços
    parede=5.0, parede_bandeja=3.5,
    logo_largura=60.0, logo_centro_z=170.0, logo_relevo=2.0, ecg_profundidade=1.2,
    texto="IASIS", texto_altura=20.0, texto_centro_z=112.0, texto_relevo=1.2,
    entrada_diametro=12.0, entrada_x=100.0, entrada_z=150.0,

    # ── Encaixes ───────────────────────────────────────────────────────────
    junta_y=100.0, macho_recuo=1.7, macho_largura=1.6, macho_comprimento=5.0,
    folga=0.25,                   # por lado (folgada para impressão rápida, sem corpo de prova)
    aba_altura=6.0, aba_espessura=2.5, aba_folga=0.3,
    corte_z=135.0,                # altura do corte da versão dividida

    # ── Tampa: 4 parafusos M3 × 16 ─────────────────────────────────────────
    tampa_parafusos=[(15, 15), (185, 15), (13, 190), (187, 190)],   # M3 × 12 escareado
    furo_guia_m3=2.5,             # furo para parafuso M3 entrar rosqueando no plástico
    furo_passante_m3=3.4,
    rebaixo_cabeca=7.0, rebaixo_tampa=12.0,   # escareado um pouco fundo: nada raspa no disco

    # ── Prateleira, disco e motor ──────────────────────────────────────────
    prateleira_topo=124.0, prateleira_espessura=5.0, apoio_largura=12,
    centro_disco=(100.0, 95.0),
    compartimentos=8,             # o firmware usa 8 (25 passos por compartimento)
    # v3: bolsos grandes (cabe bala e bala de goma) e mais largos embaixo que em
    # cima, para nada encunhar; a saída é maior que o bolso.
    raio_bolsos=48.0, bolso_diametro=30.0, bolso_alivio=1.5,   # Ø 30 em cima, Ø 31,5 embaixo
    saida_diametro=34.0, saida_chanfro=2.0,
    descanso=True,                # posição 1 sem bolso: parado em casa, nada cai sozinho
    disco_diametro=140.0, disco_altura=22.0,
    # o disco não arrasta na prateleira: o cubo apoia no ressalto do motor e o
    # disco fica `disco_folga` acima (menor que qualquer comprimido)
    disco_folga=0.8, cubo_raio=6.5, nema_ressalto_altura=2.0, furo_eixo_folga=0.25,
    # NEMA 17 (medidas da norma; o comprimento do corpo varia de 34 a 48 mm)
    nema_lado=42.3, nema_furos=31.0, nema_ressalto=22.0, nema_comprimento=48.0,
    eixo_diametro=5.0, eixo_chato=4.5, eixo_comprimento=24.0,

    # ── Calha ──────────────────────────────────────────────────────────────
    calha_x=(76.0, 124.0), calha_angulo=50.0, calha_parede=2.5, calha_topo=112.0,
    # v4: pés laterais para colar no fundo (a calha não tomba) e lingueta que passa
    # pela janela e deita na bandeja (trava a calha no lugar e leva a dose até fora)
    calha_pe=12.0, calha_ponta_z=7.5, calha_lingueta=-8.0,


    # ── Portinha de abastecimento na tampa (encaixe cônico, sai com o dedo) ─
    portinha=(40.0, 160.0, 35.0, 155.0),   # abertura embaixo da tampa: x0, x1, y0, y1
    portinha_raio=18.0, portinha_folga=0.4, portinha_furo_dedo=24.0,

    # ── Trava (servo SG90) ─────────────────────────────────────────────────
    # v6: a paleta (a "moedinha") volta para baixo da saída, como no vídeo, mas sem
    # mexer na prateleira já impressa: fica 0,5 mm abaixo dela e o suporte do servo
    # é colado por baixo (um gabarito acerta a posição). O eixo fica na frente da
    # saída e a paleta abre girando 80° para a direita, contornando o motor.
    trava=True,
    trava_eixo=(114.0, 20.0), trava_abre=-80.0,   # graus; negativo = horário visto de cima
    paleta_folga=0.5,                              # entre a paleta e a prateleira
    # Medidas típicas do SG90: confira com o corpo de prova "suporte_servo".
    sg90_corpo=(22.8, 12.2, 22.7),   # comprimento, largura, altura
    sg90_eixo_da_ponta=5.9,          # do eixo até a ponta mais próxima do corpo
    sg90_aba_do_topo=4.3,            # do topo do corpo até o topo das abas
    sg90_aba_espessura=2.5,
    sg90_furos=27.8,                 # entre os furos das abas
    sg90_braco_acima_do_topo=4.5,    # do topo do corpo até o topo do braço
    paleta_raio=19.5, paleta_espessura=2.5,    # cobre a saída de Ø 34 com 2,5 mm de sobra

    # ── Eletrônica ─────────────────────────────────────────────────────────
    lcd_furos=(75.0, 31.0), lcd_moldura_profundidade=7.0,     # LCD 16x2 padrão
    rc522_placa=(60.0, 40.0), rc522_distancia_parede=4.0,
    painel_tamanho=(54.0, 80.0), painel_espessura=3.0, painel_passo_furos=8.0,
)


# ═══════════════════════════════════════════════════════════════════════════
#  Geometria auxiliar
# ═══════════════════════════════════════════════════════════════════════════
CONTORNO = box(-1, -60, 201, 201)


def disco_2d(c, r):
    return Point(c).buffer(r, resolution=48)


def furo_escareado(x, y, z_topo, P, profundidade):
    """Furo passante M3 com escareado de 90° saindo da face de cima (z_topo)."""
    r = P["rebaixo_cabeca"] / 2
    rf = P["furo_passante_m3"] / 2
    return cad.furo_chanfrado(x, y, rf, z_topo - profundidade, z_topo, r - rf)


def apoio_45(corpo, z_topo, largura, recorte=None):
    """Aba de apoio colada nas paredes internas, em degraus de 1 mm (45°, imprime sem suporte)."""
    degraus = []
    for k in range(int(largura)):
        z1 = z_topo - k
        z0 = z1 - 1
        interior = cad.boca(corpo, z0 + 0.5, z0 + 0.5, CONTORNO)
        banda = cad.faixa_interna(interior, -0.3, largura - k + 0.3)
        if recorte is not None:
            banda = banda.difference(recorte)
        degraus.append(cad.extrudar(banda, z0, z1))
    return cad.unir(degraus)


# ═══════════════════════════════════════════════════════════════════════════
#  Carcaça
# ═══════════════════════════════════════════════════════════════════════════
def carcaca(P):
    orig = AQUI / "originais"
    tras = cad.carregar_original(orig, "tras")
    frente = cad.carregar_original(orig, "frente")
    tampa = cad.carregar_original(orig, "tampa")
    topo = 280.0
    te = P["tampa_espessura"]
    tampa = cad.recortar(tampa, -1, 201, -1, 201, topo, topo + te)
    if P["esvaziar"]:
        frente = cad.subtrair(frente, cad.caixa(5, 195, 5, 100.5, 5.5, topo + 1))
        tras = cad.subtrair(tras, cad.caixa(5, 195, 99.5, 195, 5, topo + 1))

    # 1. Frente arredondada
    R, w = P["raio_frente"], P["parede"]
    for canto, sentido in [((0, 0), (1, 1)), ((200, 0), (-1, 1))]:
        frente = cad.arredondar_canto_vertical(frente, canto, sentido, R, 0, topo, parede=w)
        tampa = cad.arredondar_canto_vertical(tampa, canto, sentido, R, topo, topo + te)
    tampa = cad.arredondar_aresta(tampa, "YZ", (0, topo + te), (1, -1), P["raio_tampa_frente"], 0, 200)
    for canto, sentido in [((35, -50), (1, 1)), ((165.1, -50), (-1, 1))]:
        frente = cad.arredondar_canto_vertical(frente, canto, sentido, P["raio_bandeja"], 0, 15.5,
                                               parede=P["parede_bandeja"])

    # 2. Logo e nome
    coracao, ecg = cad.logo_2d(P["logo_largura"])
    centro = (100, P["logo_centro_z"])
    relevo = cad.relevo_na_face_frontal(coracao, 0.0, P["logo_relevo"], centro)
    sulco = cad.relevo_na_face_frontal(ecg, -(P["logo_relevo"] - P["ecg_profundidade"]),
                                       P["ecg_profundidade"] + 0.5, centro)
    nome = cad.relevo_na_face_frontal(cad.texto_2d(P["texto"], P["texto_altura"]), 0.0,
                                      P["texto_relevo"], (100, P["texto_centro_z"]))
    frente = cad.unir([frente, cad.subtrair(relevo, sulco), nome])

    # 3. Entrada de energia
    ex, ez = P["entrada_x"], P["entrada_z"]
    esp = cad.espessura_ao_longo(tras, (ex, 200, ez), (0, -1, 0))
    tras = cad.subtrair(tras, cad.cilindro(P["entrada_diametro"] / 2, (ex, 201, ez), (ex, 200 - esp - 1, ez)))

    # 4. Fixações internas na parte da frente
    fix = []
    # 4a. LCD 16x2: 4 pinos na parede da frente, atrás da janela (centro X 100, Z 257,5)
    lx, lz = P["lcd_furos"]
    prof = P["lcd_moldura_profundidade"]
    for sx in (-1, 1):
        for sz in (-1, 1):
            x, z = 100 + sx * lx / 2, 257.5 + sz * lz / 2
            fix.append(cad.subtrair(cad.cilindro(3.0, (x, 4.5, z), (x, 5 + prof, z)),
                                    cad.cilindro(P["furo_guia_m3"] / 2, (x, 6.5, z), (x, 6 + prof, z))))
    # 4b. RC522: dois trilhos com canal, atrás do coração (a placa desce por cima)
    pl, ph = P["rc522_placa"]
    yp = 5 + P["rc522_distancia_parede"]
    for lado in (-1, 1):
        borda = 100 + lado * pl / 2
        x0, x1 = sorted([borda - lado * 1.5, borda + lado * 4.5])
        trilho = cad.caixa(x0, x1, 4.5, yp + 3.5, 148, 195)
        canal_x0, canal_x1 = sorted([borda - lado * 2.0, borda + lado * 0.5])
        canal = cad.caixa(canal_x0, canal_x1, yp - 0.2, yp + 1.8, 150, 196)
        fix.append(cad.subtrair(trilho, canal))
    # 4c. Painéis de eletrônica nas paredes laterais (4 pinos cada)
    pw, ph_ = P["painel_tamanho"]
    for x_parede, sentido, zc in [(5.0, 1, 205.0), (195.0, -1, 180.0)]:
        for y in (45.0, 85.0):
            for z in (zc - 33, zc + 33):
                pino = cad.cilindro(4.0, (x_parede - sentido * 0.5, y, z), (x_parede + sentido * 8, y, z))
                guia = cad.cilindro(P["furo_guia_m3"] / 2, (x_parede + sentido * 1.5, y, z),
                                    (x_parede + sentido * 9, y, z))
                fix.append(cad.subtrair(pino, guia))
    # 4d. Ressaltos para os parafusos da tampa nos cantos da frente, com base em cone
    for (x, y) in P["tampa_parafusos"][:2]:
        fix.append(cad.cilindro(6.0, (x, y, 262), (x, y, 280)))
        fix.append(cad.cone(6.0, 6.0, (x, y, 262.01)))
    frente = cad.unir([frente] + fix)
    # ressaltos dos parafusos de trás (colados na parede de trás)
    tras = cad.unir([tras] + [m for (x, y) in P["tampa_parafusos"][2:]
                              for m in (cad.cilindro(6.0, (x, y, 262), (x, y, 280)),
                                        cad.cone(6.0, 6.0, (x, y, 262.01)))])

    # 5. Apoio da prateleira (as duas metades), aberto no meio da frente para a calha passar
    corpo = cad.unir([tras, frente])
    zb = P["prateleira_topo"] - P["prateleira_espessura"]
    apoio = apoio_45(corpo, zb, P["apoio_largura"], recorte=box(72, -1, 128, 30))
    frente = cad.unir([frente, cad.intersectar(apoio, cad.caixa(-1, 201, -60, 100, 0, 300))])
    tras = cad.unir([tras, cad.intersectar(apoio, cad.caixa(-1, 201, 100, 201, 0, 300))])

    # 6. Furos-guia dos parafusos da tampa (nos ressaltos)
    guias = [cad.cilindro(P["furo_guia_m3"] / 2, (x, y, 281), (x, y, 266))
             for (x, y) in P["tampa_parafusos"]]
    frente = cad.subtrair(frente, guias[:2])
    tras = cad.subtrair(tras, guias[2:])

    # 7. Encaixe macho-fêmea entre as metades
    jy = P["junta_y"]
    face = cad.secao(tras, "y", jy + 0.05).intersection(cad.secao(frente, "y", jy - 0.05))
    macho2d, femea2d = cad.macho_femea(face, P["macho_recuo"], P["macho_largura"],
                                       P["macho_comprimento"], P["folga"])
    L = P["macho_comprimento"]
    tras = cad.unir([tras, cad.extrudar_no_plano(macho2d, "XZ", jy - L, jy + 0.5)])
    frente = cad.subtrair(frente, cad.extrudar_no_plano(femea2d, "XZ", jy - L - 0.5, jy + 0.01))

    # 8. Tampa: aba que entra na boca e 4 furos com rebaixo para a cabeça
    corpo = cad.unir([tras, frente])
    abertura = cad.boca(corpo, topo - P["aba_altura"] - 0.5, topo - 0.01, CONTORNO)
    aba2d = cad.faixa_interna(abertura, P["aba_folga"], P["aba_espessura"])
    aba2d = aba2d.difference(box(55, -1, 145, 25))     # a placa do LCD sobe até perto do topo
    aba = cad.extrudar(aba2d, topo - P["aba_altura"], topo + 0.5)
    tampa = cad.unir([tampa, aba])
    tampa = cad.subtrair(tampa, [furo_escareado(x, y, topo + te, P, te)
                                 for (x, y) in P["tampa_parafusos"]])

    # 9. Abertura de abastecimento: cone de 45° (mais larga em cima) e portinha que assenta nela
    tampa = cad.subtrair(tampa, tronco_portinha(P, topo - 1, topo + te + 1, 0.0))
    folga_p = P["portinha_folga"]
    portinha = tronco_portinha(P, topo + folga_p, topo + te, -folga_p)
    xd = (P["portinha"][0] + P["portinha"][1]) / 2
    yd = P["portinha"][3] - P["portinha_furo_dedo"] / 2 - 8
    portinha = cad.subtrair(portinha, cad.cilindro(P["portinha_furo_dedo"] / 2, (xd, yd, topo - 1),
                                                   (xd, yd, topo + te + 1)))

    return dict(tras=tras, frente=frente, tampa=tampa, portinha=portinha), dict(entrada_espessura=esp)


def retangulo_arredondado(x0, x1, y0, y1, r):
    return box(x0 + r, y0 + r, x1 - r, y1 - r).buffer(r, resolution=16)


def tronco_portinha(P, z0, z1, recuo):
    """Tronco de pirâmide de 45° com a forma da abertura da tampa (z = topo da casca é a medida
    `portinha`). `recuo` negativo encolhe (folga da portinha). Convexo: casca convexa de duas camadas."""
    import trimesh
    x0, x1, y0, y1 = P["portinha"]
    topo = 280.0
    camadas = []
    for z in (z0, z1):
        d = (z - topo) + recuo           # 45°: cresce 1 mm para cada 1 mm de altura
        f = retangulo_arredondado(x0 - d, x1 + d, y0 - d, y1 + d, P["portinha_raio"] + d)
        xy = np.asarray(f.exterior.coords)[:-1]
        camadas.append(np.column_stack([xy, np.full(len(xy), z)]))
    return trimesh.convex.convex_hull(np.vstack(camadas))


# ═══════════════════════════════════════════════════════════════════════════
#  Mecanismo
# ═══════════════════════════════════════════════════════════════════════════
def geometria_trava(P):
    """Posições da trava: saída (compartimento na frente) e eixo do servo."""
    cx, cy = P["centro_disco"]
    return (cx, cy - P["raio_bolsos"]), tuple(P["trava_eixo"])


def paleta_2d(P, angulo_extra=0.0):
    """Paleta vista de cima: disco sobre a saída + braço até o eixo. Fechada em 0°;
    abre girando `trava_abre` graus em volta do eixo."""
    from shapely.geometry import LineString
    saida, eixo = geometria_trava(P)
    forma = disco_2d(saida, P["paleta_raio"]).union(LineString([saida, eixo]).buffer(4.0)).union(
        disco_2d(eixo, 5.0))
    from shapely import affinity
    return affinity.rotate(forma, angulo_extra, origin=eixo)


def mecanismo(P, carcaca_pecas):
    cx, cy = P["centro_disco"]
    zt = P["prateleira_topo"]
    zb = zt - P["prateleira_espessura"]
    saida, eixo = geometria_trava(P)
    corpo = cad.unir([carcaca_pecas["tras"], carcaca_pecas["frente"]])


    # ── Prateleira: passa pela boca de cima e assenta no apoio ─────────────
    contorno = cad.boca(corpo, zb + 0.5, 279.9, CONTORNO).buffer(-0.5)
    prat = cad.extrudar(contorno, zb, zt)
    cortes = [cad.cilindro(P["nema_ressalto"] / 2 + 0.4, (cx, cy, zt + 1), (cx, cy, zb - 1))]
    h = P["nema_furos"] / 2
    for sx in (-1, 1):
        for sy in (-1, 1):
            cortes.append(furo_escareado(cx + sx * h, cy + sy * h, zt, P, P["prateleira_espessura"]))
    # saída dos remédios: maior que o bolso, com chanfro em cima para nada enroscar
    cortes.append(cad.furo_chanfrado(*saida, P["saida_diametro"] / 2, zb, zt, P["saida_chanfro"]))
    # passagem de fios do motor e do servo, fora do giro do disco
    for x in (22.0, 178.0):
        cortes.append(cad.caixa(x - 6, x + 6, cy - 12, cy + 12, zb - 1, zt + 1))
    prat = cad.subtrair(prat, cortes)
    # marca do compartimento 1 (seta gravada na frente do disco)
    seta = Polygon([(cx - 4, cy - P["disco_diametro"] / 2 - 9), (cx + 4, cy - P["disco_diametro"] / 2 - 9),
                    (cx, cy - P["disco_diametro"] / 2 - 3)])
    prat = cad.subtrair(prat, cad.extrudar(seta, zt - 0.6, zt + 1))

    # ── Disco de compartimentos ────────────────────────────────────────────
    from shapely import affinity
    z0 = zt + P["disco_folga"]
    z1 = z0 + P["disco_altura"]
    n = P["compartimentos"]
    disco = cad.cilindro(P["disco_diametro"] / 2, (cx, cy, z0), (cx, cy, z1), secoes=128)
    # cubo por baixo: entra no furo da prateleira e apoia no ressalto do motor
    z_cubo = zb + P["nema_ressalto_altura"]
    disco = cad.unir([disco, cad.cilindro(P["cubo_raio"], (cx, cy, z_cubo), (cx, cy, z0 + 0.5))])
    cortes = []
    rb = P["bolso_diametro"] / 2
    rbb = rb + P["bolso_alivio"] / 2
    angulos = [-90 - k * 360 / n for k in range(n)]   # posição 1 na saída; sentido horário
    for k, a in enumerate(angulos):
        px = cx + P["raio_bolsos"] * math.cos(math.radians(a))
        py = cy + P["raio_bolsos"] * math.sin(math.radians(a))
        if k == 0 and P["descanso"]:
            # posição de descanso (fica sobre a saída quando o disco está em casa): coração gravado
            coracao, _ = cad.logo_2d(18.0)
            cortes.append(cad.extrudar(affinity.translate(coracao, px, py), z1 - 0.8, z1 + 1))
            continue
        # bolso passante, 0,75 mm mais largo embaixo: o que entra solto sai solto
        cortes.append(cad.revolucao([(0, z0 - 1), (rbb, z0 - 1), (rbb, z0), (rb, z1 - 1.0),
                                     (rb + 2.0, z1 + 1), (0, z1 + 1)], (px, py)))
        num = cad.texto_2d(str(k if P["descanso"] else k + 1), 5.0)
        rn = P["disco_diametro"] / 2 - 3.5
        num = affinity.rotate(num, a + 90, origin=(0, 0))
        num = affinity.translate(num, cx + rn * math.cos(math.radians(a)), cy + rn * math.sin(math.radians(a)))
        cortes.append(cad.extrudar(num, z1 - 0.6, z1 + 1))
    # furo do eixo em D (eixo de 5 mm com rebaixo plano)
    fe = P["furo_eixo_folga"]
    furo = disco_2d((cx, cy), P["eixo_diametro"] / 2 + fe).intersection(
        box(cx - 5, cy - 5, cx + 5, cy - P["eixo_diametro"] / 2 + P["eixo_chato"] + fe))
    cortes.append(cad.extrudar(furo, z_cubo - 1, z1 + 1))
    # marca do compartimento 1 na borda
    cortes.append(cad.caixa(cx - 1.2, cx + 1.2, cy - P["disco_diametro"] / 2 - 1,
                            cy - P["disco_diametro"] / 2 + 2.5, z0 - 1, z1 + 1))
    disco = cad.subtrair(disco, cortes)

    # ── Paleta da trava (a "moedinha"), logo abaixo da prateleira ──────────
    pz1 = zb - P["paleta_folga"]
    pz0 = pz1 - P["paleta_espessura"]
    paleta = cad.extrudar(paleta_2d(P, 0), pz0, pz1)
    ux, uy = saida[0] - eixo[0], saida[1] - eixo[1]
    norma = math.hypot(ux, uy)
    ux, uy = ux / norma, uy / norma
    # rebaixo para a cabeça do parafuso do braço e dois furinhos ao longo do braço
    paleta = cad.subtrair(paleta, [cad.cilindro(3.2, (*eixo, pz0 - 1), (*eixo, pz0 + 1.5))] + [
        cad.cilindro(0.8, (eixo[0] + r * ux, eixo[1] + r * uy, pz0 - 1), (eixo[0] + r * ux, eixo[1] + r * uy, pz1 + 1))
        for r in (9.0, 15.0)])

    # ── Servo SG90 (eixo para cima, corpo para −X) e suporte colado embaixo da prateleira ──
    cl, cw, ch = P["sg90_corpo"]
    ef = P["sg90_eixo_da_ponta"]
    topo_servo = pz0 - P["sg90_braco_acima_do_topo"]
    sx0, sx1 = eixo[0] - (cl - ef), eixo[0] + ef
    sy0, sy1 = eixo[1] - cw / 2, eixo[1] + cw / 2
    centro_corpo = (sx0 + sx1) / 2
    aba_topo = topo_servo - P["sg90_aba_do_topo"]
    aba_base = aba_topo - P["sg90_aba_espessura"]
    base_z0 = aba_base - 3.0
    bx0, bx1 = centro_corpo - 17.2, centro_corpo + 17.2          # base sob as duas abas
    by0, by1 = sy0 - 4.0, sy1 + 0.5
    yf = 6.5                                                     # 1,5 mm atrás da parede da frente
    # base em U (aberta para trás: o servo entra deslizando), parede da frente e da esquerda
    # até a prateleira, com abas de colar em cima. Tudo longe do giro da paleta (atrás e à direita).
    base = cad.subtrair(cad.caixa(bx0, bx1, by0, by1, base_z0, aba_base),
                        cad.caixa(sx0 - 0.3, sx1 + 0.3, sy0 - 0.3, by1 + 1, base_z0 - 1, aba_base + 1))
    furos_abas = [centro_corpo - P["sg90_furos"] / 2, centro_corpo + P["sg90_furos"] / 2]
    y_esq = saida[1] - P["paleta_raio"] - 1.5                     # a esquerda para antes do disco da paleta
    suporte = cad.unir([
        base,
        cad.caixa(bx0 - 3, bx1, yf, by0 + 3, base_z0, zb),             # parede da frente
        cad.caixa(bx0 - 3, bx0, yf, min(by1, y_esq), base_z0, zb),     # parede da esquerda
        cad.caixa(bx0 - 3, bx1, yf, eixo[1] - 6.0, zb - 3, zb),        # aba de colar (frente)
        cad.caixa(bx0 - 9, bx0, yf, min(by1, y_esq), zb - 3, zb),      # aba de colar (esquerda)
        # reforço a 45° embaixo da aba da esquerda: o suporte imprime de pé, base em U na mesa
        cad.extrudar_no_plano(Polygon([(bx0 - 2.9, zb - 3.1), (bx0 - 9, zb - 3.1), (bx0 - 2.9, zb - 9.2)]),
                              "XZ", yf, min(by1, y_esq)),
    ])
    furos_suporte = [(bx0 - 4.5, yf + 2.5), (bx1 - 3.0, yf + 2.5)]  # M3 opcional, de cima, furando a prateleira
    suporte = cad.subtrair(suporte, [cad.cilindro(0.9, (x, eixo[1], base_z0 - 1), (x, eixo[1], aba_base + 1))
                                     for x in furos_abas] +
                           [cad.cilindro(P["furo_guia_m3"] / 2, (x, y, zb + 1), (x, y, zb - 10))
                            for (x, y) in furos_suporte])

    # Gabarito para colar o suporte: deita na prateleira de cabeça para baixo, com o pino na
    # saída e a borda encostada na frente da prateleira; as abas do suporte entram nos recortes.
    abas = cad.sombra_xy(cad.intersectar(suporte, cad.caixa(0, 200, 0, 200, zb - 3.5, zb + 1)))
    pegada = unary_union([Polygon(g.exterior) for g in getattr(abas, "geoms", [abas])])   # sem os furinhos
    y_frente = contorno.bounds[1]
    placa = box(bx0 - 14, y_frente - 2.5, bx1 + 6, saida[1] + 22).difference(pegada.buffer(0.3))
    gabarito = cad.unir([
        cad.extrudar(placa, zb - 2.0, zb),
        cad.cilindro(P["saida_diametro"] / 2 - 0.25, (*saida, zb - 0.01), (*saida, zb + 4.0)),
        cad.caixa(bx0 - 14, bx1 + 6, y_frente - 2.5, y_frente - 0.3, zb - 2.0, zb + 3.0),
    ])

    # ── Calha: leva o remédio da saída até a janela da bandeja ─────────────
    # Rampa de chapa a 50° (bala de goma desliza em PLA a partir de ~40°), mais
    # larga que a saída e com paredes altas para nada quicar para fora.
    xa, xb = P["calha_x"]
    pc, ct = P["calha_parede"], P["calha_topo"]
    tg = math.tan(math.radians(P["calha_angulo"]))
    y_fim = 70.0
    zp = P["calha_ponta_z"]                                         # topo da rampa na ponta da frente
    z_fim = zp + (y_fim - 6) * tg
    grossura = 3.0 / math.cos(math.radians(P["calha_angulo"]))     # chapa de 3 mm
    rampa2d = Polygon([(6, 5.5), (6 + (grossura - (zp - 5.5)) / tg, 5.5), (y_fim, z_fim - grossura),
                       (y_fim, z_fim), (6, zp)])
    lado = Polygon([(6, 5.5), (y_fim + pc, 5.5), (y_fim + pc, ct), (30, ct), (6, 30)])
    ri0, ri1 = xa + pc - 0.5, xb - pc + 0.5                         # largura da rampa
    pe_l, yt = P["calha_pe"], y_fim + pc
    partes = [
        cad.extrudar_no_plano(rampa2d, "YZ", ri0, ri1),
        cad.extrudar_no_plano(lado, "YZ", xa, xa + pc),
        cad.extrudar_no_plano(lado, "YZ", xb - pc, xb),
        cad.caixa(xa, xb, y_fim, yt, 5.5, ct),
        # lingueta: mesma altura da ponta da rampa, atravessa a janela e deita na bandeja
        cad.caixa(ri0, ri1, P["calha_lingueta"], 6.5, 5.5, zp),
        # pés para colar no fundo; começam em Y 18 para passar pelo apoio da prateleira
        cad.caixa(xa - pe_l, xa + 0.5, 18, yt + 8, 5.5, 7.5),
        cad.caixa(xb - 0.5, xb + pe_l, 18, yt + 8, 5.5, 7.5),
        cad.caixa(xa - pe_l, xb + pe_l, yt - 0.5, yt + 8, 5.5, 7.5),
    ]
    for y in (28.0, 48.0, 66.0):                                    # reforços entre pé e parede
        for x0, x1 in ((xa - pe_l + 1, xa + 0.5), (xb - 0.5, xb + pe_l - 1)):
            dentro, fora = (x1, x0) if x0 < xa else (x0, x1)
            tri = Polygon([(fora, 7.4), (dentro, 7.4), (dentro, 30)])
            partes.append(cad.extrudar_no_plano(tri, "XZ", y, y + 2.5))
    calha = cad.unir(partes)

    # ── Painéis de eletrônica (2 iguais): grade de furos para M3 ou abraçadeira
    pw, ph = P["painel_tamanho"]
    pe = P["painel_espessura"]
    painel = cad.caixa(0, pe, 0, pw, 0, ph)
    furos = []
    passo = P["painel_passo_furos"]
    for y in np.arange(passo, pw - passo / 2, passo):
        for z in np.arange(passo, ph - passo / 2, passo):
            furos.append(cad.cilindro(1.7, (-1, y, z), (pe + 1, y, z), secoes=16))
    for y in (45.0 - 38.0, 85.0 - 38.0):
        for z in (40 - 33, 40 + 33):
            furos.append(cad.cilindro(1.75, (-1, y, z), (pe + 1, y, z)))
    painel_base = cad.subtrair(painel, furos)
    painel_esq = painel_base.copy(); painel_esq.apply_translation([13.0, 38.0, 205.0 - 40])
    painel_dir = painel_base.copy(); painel_dir.apply_translation([187.0 - pe, 38.0, 180.0 - 40])

    pecas = dict(prateleira=prat, disco=disco, paleta=paleta, suporte_servo=suporte, calha=calha,
                 painel_esq=painel_esq, painel_dir=painel_dir)

    # ── Fantasmas dos componentes (só para conferir colisão) ───────────────
    nl, ncomp = P["nema_lado"], P["nema_comprimento"]
    fant = dict(
        motor=cad.unir([cad.caixa(cx - nl / 2, cx + nl / 2, cy - nl / 2, cy + nl / 2, zb - ncomp, zb),
                        cad.cilindro(P["nema_ressalto"] / 2, (cx, cy, zb), (cx, cy, zb + P["nema_ressalto_altura"])),
                        cad.extrudar(disco_2d((cx, cy), P["eixo_diametro"] / 2).intersection(
                            box(cx - 5, cy - 5, cx + 5, cy - P["eixo_diametro"] / 2 + P["eixo_chato"])),
                            zb, zb + P["eixo_comprimento"])]),
        servo=cad.unir([cad.caixa(sx0, sx1, sy0, sy1, topo_servo - ch, topo_servo),
                        cad.caixa(centro_corpo - 16.2, centro_corpo + 16.2, sy0, sy1, aba_base, aba_topo)]),
        lcd=cad.unir([cad.caixa(64.4, 135.6, 5.0, 5 + prof_lcd(P), 245.4, 269.6),
                      cad.caixa(60, 140, 5 + prof_lcd(P), 6.6 + prof_lcd(P), 239.5, 275.5)]),
        rc522=cad.caixa(100 - P["rc522_placa"][0] / 2, 100 + P["rc522_placa"][0] / 2,
                        5 + P["rc522_distancia_parede"], 6.6 + P["rc522_distancia_parede"], 150, 150 + P["rc522_placa"][1]),
    )
    if not P["trava"]:
        for k in ("paleta", "suporte_servo"):
            pecas.pop(k)
        fant.pop("servo")
    else:
        pecas["gabarito_trava"] = gabarito
    info = dict(saida=saida, eixo=eixo, contorno_prateleira=contorno, furos_suporte=furos_suporte)
    return pecas, fant, info




def prof_lcd(P):
    return P["lcd_moldura_profundidade"]


# ═══════════════════════════════════════════════════════════════════════════
#  Versão dividida e corpos de prova
# ═══════════════════════════════════════════════════════════════════════════
def dividir(peca, P):
    """Corta uma metade do corpo na altura `corte_z`, com macho embaixo e fêmea em cima."""
    zc = P["corte_z"]
    baixo = cad.recortar(peca, -10, 210, -60, 210, -1, zc)
    cima = cad.recortar(peca, -10, 210, -60, 210, zc, 310)
    face = cad.secao(peca, "z", zc)
    macho2d, femea2d = cad.macho_femea(face, P["macho_recuo"], P["macho_largura"],
                                       P["macho_comprimento"], P["folga"])
    L = P["macho_comprimento"]
    baixo = cad.unir([baixo, cad.extrudar(macho2d, zc - 0.5, zc + L)])
    cima = cad.subtrair(cima, cad.extrudar(femea2d, zc - 0.01, zc + L + 0.5))
    return baixo, cima


def corpos_de_prova(p, P):
    zc = P["corte_z"]
    cx, cy = P["centro_disco"]
    _, eixo = geometria_trava(P)
    return {
        "1_junta_parte_de_tras": cad.recortar(p["tras"], -1, 30, 94, 112, 140, 165),
        "1_junta_parte_da_frente": cad.recortar(p["frente"], -1, 30, 88, 100.5, 140, 165),
        "2_tampa_canto": cad.recortar(p["tampa"], -1, 45, -1, 45, 270, 290),
        "2_corpo_canto_topo": cad.recortar(p["frente"], -1, 45, -1, 45, 255, 280),
        "3_divisao_baixo": cad.recortar(p["frente_baixo"], -1, 30, 40, 70, zc - 15, zc + 10),
        "3_divisao_cima": cad.recortar(p["frente_cima"], -1, 30, 40, 70, zc - 1, zc + 15),
        "4_disco_centro_no_eixo": cad.intersectar(p["disco"], cad.cilindro(16, (cx, cy, 100), (cx, cy, 200), secoes=128)),
        "5_tampa_portinha_canto": cad.recortar(p["tampa"], 20, 75, 15, 70, 270, 290),
        "5_portinha_canto": cad.recortar(p["portinha"], 20, 75, 15, 70, 270, 290),
        **({"6_suporte_servo": p["suporte_servo"]} if "suporte_servo" in p else {}),
    }


# ═══════════════════════════════════════════════════════════════════════════
#  Verificação
# ═══════════════════════════════════════════════════════════════════════════
def verificar(pecas, fant, info, P):
    ok = True
    print("── Peças (estanque, 1 corpo)")
    for n, m in pecas.items():
        print("  " + cad.relatorio(n, m))
        bom = m.is_watertight and m.body_count == 1
        ok &= bom
        if not bom:
            print(f"  ✗ {n} com problema na malha")

    print("── Sobreposição na montagem (tem que dar ~0 mm³)")
    montadas = {k: v for k, v in pecas.items() if not k.endswith(("_baixo", "_cima")) and k != "gabarito_trava"}
    tudo = {**montadas, **{f"[{k}]": v for k, v in fant.items()}}
    piores = []
    for (a, ma), (b, mb) in combinations(tudo.items(), 2):
        if a.startswith("[") and b.startswith("["):
            continue
        if not _caixas_tocam(ma, mb):
            continue
        v = cad.interferencia(ma, mb)
        if v > 1.0:
            piores.append((v, a, b))
    for v, a, b in sorted(piores, reverse=True):
        print(f"  ✗ {a} × {b}: {v:.1f} mm³")
    ok &= not piores
    if not piores:
        print("  todas as combinações ~0")

    abre = P["trava_abre"]
    print(f"── Paleta girando de 0° a {abs(abre):.0f}° (fechada → aberta)")
    saida_t, eixo = geometria_trava(P)
    colisoes = set()
    passo = 5 if abre > 0 else -5
    for ang in (range(0, int(abre) + passo, passo) if "paleta" in pecas else []):
        pal = cad.girar(pecas["paleta"], ang, (0, 0, 1), (*eixo, 0))
        for n in ("prateleira", "disco", "suporte_servo", "calha", "frente", "tras"):
            if cad.interferencia(pal, pecas[n]) > 1.0:
                colisoes.add(n)
        for n in ("motor", "servo"):
            if cad.interferencia(pal, fant[n]) > 1.0:
                colisoes.add("[" + n + "]")
    print(("  sem colisão" if "paleta" in pecas else "  trava desligada (sem paleta)") if not colisoes
          else f"  ✗ bate em: {sorted(colisoes)}")
    ok &= not colisoes
    if "paleta" in pecas:
        from shapely import affinity
        aberta = affinity.rotate(disco_2d(saida_t, P["paleta_raio"]), abre, origin=eixo)
        livre = aberta.distance(disco_2d(saida_t, P["saida_diametro"] / 2))
        print(f"  aberta, a paleta fica {livre:.1f} mm longe da saída (a dose cai livre)")
        ok &= livre >= 1.0

    print("── Caminho da dose (bolso → saída → calha → bandeja)")
    rb = P["bolso_diametro"] / 2
    rbb = rb + P["bolso_alivio"] / 2
    rs = P["saida_diametro"] / 2
    passo = 2 * P["raio_bolsos"] * math.sin(math.pi / P["compartimentos"])
    folga_saida = rs - rbb
    cobre_vizinho = passo - rbb - rs        # quanto da prateleira separa a saída do bolso vizinho
    xa, xb = P["calha_x"]
    sx, sy = info["saida"]
    na_calha = (xa + P["calha_parede"] <= sx - rs and sx + rs <= xb - P["calha_parede"]
                and 6 <= sy - rs and sy + rs <= 70)
    print(f"  bolso Ø {2 * rb:.0f} em cima / Ø {2 * rbb:.1f} embaixo, saída Ø {2 * rs:.0f}: "
          f"{folga_saida:.2f} mm de sobra em volta")
    print(f"  prateleira entre a saída e o bolso vizinho: {cobre_vizinho:.1f} mm (parado, o vizinho não cai)")
    print(f"  queda inteira dentro da calha: {'sim' if na_calha else '✗ NÃO'}; rampa a {P['calha_angulo']:.0f}°")
    print(f"  disco {P['disco_folga']:.1f} mm acima da prateleira (apoiado pelo cubo no ressalto do motor)")
    bom = folga_saida >= 1.0 and cobre_vizinho >= 2.0 and na_calha and P["calha_angulo"] >= 45
    ok &= bom

    print("── Peças que entram pela boca de cima (prateleira, disco)")
    corpo = cad.unir([pecas["tras"], pecas["frente"]])
    boca = cad.boca(corpo, 150, 279.9, CONTORNO)
    for n in [k for k in ("prateleira", "disco", "suporte_servo") if k in pecas]:   # calha: logo abaixo
        pegada = (cad.secao(pecas[n], "z", PARAMETROS["prateleira_topo"] - 2.5) if n == "prateleira"
                  else _sombra_xy(pecas[n]))
        cabe = boca.buffer(0.01).contains(pegada)
        print(f"  {n}: {'passa' if cabe else '✗ NÃO passa'}")
        ok &= cabe

    print("── Calha desce afastada 13 mm da frente e passa pelo apoio da prateleira")
    afastada = pecas["calha"].copy()
    afastada.apply_translation([0, 13, 0])
    sombra = cad.sombra_xy(afastada)
    for z0, z1 in ((107.5, 118.5), (150, 279.9)):
        livre = cad.boca(corpo, z0, z1, CONTORNO).buffer(0.01).contains(sombra)
        print(f"  Z {z0:.0f}–{z1:.0f}: {'passa' if livre else '✗ NÃO passa'}")
        ok &= livre

    print("── Furos-guia dos parafusos da tampa com plástico em volta (≥ 1,5 mm)")
    for (x, y) in P["tampa_parafusos"]:
        anel = cad.subtrair(cad.cilindro(P["furo_guia_m3"] / 2 + 1.5, (x, y, 268), (x, y, 279.5)),
                            cad.cilindro(P["furo_guia_m3"] / 2 + 0.01, (x, y, 267), (x, y, 281)))
        dentro = cad.intersectar(anel, corpo).volume / anel.volume
        print(f"  ({x}, {y}): {dentro * 100:.0f}% de material")
        ok &= dentro > 0.97

    print("── Tudo certo" if ok else "── ATENÇÃO: verificação falhou")
    return ok


def _caixas_tocam(a, b):
    la, ha = a.bounds
    lb, hb = b.bounds
    return np.all(la <= hb + 0.01) and np.all(lb <= ha + 0.01)


def _sombra_xy(m):
    from shapely.geometry import MultiPoint
    return MultiPoint(m.vertices[:, :2]).convex_hull


# ═══════════════════════════════════════════════════════════════════════════
#  Saída
# ═══════════════════════════════════════════════════════════════════════════
# Como cada peça vai na mesa: direção (no referencial de montagem) que fica para baixo
ORIENTACAO = {
    "corpo_parte_de_tras": (0, 1, 0),     # costas na mesa
    "corpo_parte_da_frente": (0, 0, -1),  # de pé
    "tampa": (0, 0, 1),                   # de cabeça para baixo (aba para cima)
    "prateleira": (0, 0, 1),              # de cabeça para baixo (lisa na mesa)
    "disco": (0, 0, 1),                   # de cabeça para baixo: o cubo fica para cima
    "portinha": (0, 0, 1),                # face de cima na mesa (o cone de 45° sobe sem suporte)
    "paleta": (0, 0, -1),
    "suporte_servo": (0, 0, -1),          # base em U na mesa, abas de colar em cima
    "calha": (0, 0, -1),
    "gabarito_trava": (0, 0, 1),          # placa na mesa, pino e borda para cima
    "painel_eletronica": (-1, 0, 0),      # deitado
}


def salvar(pecas, P):
    saida = AQUI / "saida"
    for pasta in ("montagem", "imprimir_inteiro", "imprimir_dividido", "corpo_de_prova"):
        for velho in (saida / pasta).glob("*.stl"):      # nada de peça antiga no pacote
            velho.unlink()
    nomes = {"tras": "corpo_parte_de_tras", "frente": "corpo_parte_da_frente", "tampa": "tampa",
             "portinha": "portinha", "prateleira": "prateleira", "disco": "disco", "paleta": "paleta",
             "suporte_servo": "suporte_servo", "calha": "calha", "gabarito_trava": "gabarito_trava"}
    nomes = {k: v for k, v in nomes.items() if k in pecas}
    for k, nome in nomes.items():
        cad.salvar_stl(pecas[k], saida / "montagem" / f"{nome}.stl")
        cad.salvar_stl(cad.para_impressao(pecas[k], ORIENTACAO[nome]), saida / "imprimir_inteiro" / f"{nome}.stl")
    cad.salvar_stl(pecas["painel_esq"], saida / "montagem" / "painel_eletronica_esquerdo.stl")
    cad.salvar_stl(pecas["painel_dir"], saida / "montagem" / "painel_eletronica_direito.stl")
    painel = cad.para_impressao(pecas["painel_esq"], ORIENTACAO["painel_eletronica"])
    cad.salvar_stl(painel, saida / "imprimir_inteiro" / "painel_eletronica_x2.stl")

    # versão dividida: corpo em 4; o resto igual
    div = saida / "imprimir_dividido"
    for k in [k for k in ("tampa", "portinha", "prateleira", "disco", "paleta", "suporte_servo", "calha",
                          "gabarito_trava") if k in pecas]:
        cad.salvar_stl(cad.para_impressao(pecas[k], ORIENTACAO[nomes[k]]), div / f"{nomes[k]}.stl")
    cad.salvar_stl(painel, div / "painel_eletronica_x2.stl")
    for k, baixo in [("tras_baixo", (0, 1, 0)), ("tras_cima", (0, 1, 0)),
                     ("frente_baixo", (0, 0, -1)), ("frente_cima", (0, 0, -1))]:
        nome = {"tras": "corpo_tras", "frente": "corpo_frente"}[k.split("_")[0]] + "_" + k.split("_")[1]
        cad.salvar_stl(cad.para_impressao(pecas[k], baixo), div / f"{nome}.stl")

    for nome, m in corpos_de_prova(pecas, P).items():
        baixo = (0, 0, 1) if nome.startswith(("2_tampa", "4_disco", "5_")) else (0, 0, -1)
        cad.salvar_stl(cad.para_impressao(m, baixo), saida / "corpo_de_prova" / f"{nome}.stl")
    return saida


def previas(pecas, fant, P, pasta):
    pasta.mkdir(parents=True, exist_ok=True)
    casca = [pecas["tras"], pecas["frente"], pecas["tampa"], pecas["portinha"]]
    render.renderizar(casca, pasta / "montagem.png", vistas=("iso", "frente", "iso_tras", "direita"),
                      titulos=["isométrica", "frente", "traseira", "lateral direita"])
    # por dentro: sem a tampa e sem a metade da frente
    cor = {"tras": "#7fa7d9", "prateleira": "#e6d36f", "disco": "#e0a96d", "paleta": "#d98fb5",
           "suporte_servo": "#c9c9c9", "calha": "#9fd39a", "painel_esq": "#b0b0b0", "painel_dir": "#b0b0b0",
           "[motor]": "#555555", "[servo]": "#3a6ea5"}

    def lista(nomes):
        ms, cs = [], []
        for n in nomes:
            m = fant.get(n[1:-1]) if n.startswith("[") else pecas.get(n)
            if m is not None:
                ms.append(m); cs.append(cor[n])
        return ms, cs
    ms, cs = lista(["tras", "prateleira", "disco", "paleta", "suporte_servo", "calha", "painel_esq",
                    "painel_dir", "[motor]", "[servo]"])
    render.renderizar(ms, pasta / "interior.png", vistas=("iso", (-20, 55), "frente"),
                      titulos=["interior (sem frente e tampa)", "interior visto de cima", "interior de frente"],
                      cores=cs)
    ms, cs = lista(["prateleira", "disco", "paleta", "suporte_servo", "calha", "[motor]", "[servo]"])
    render.renderizar(ms, pasta / "mecanismo.png", vistas=("iso", (-35, -30), "topo"),
                      titulos=["mecanismo", "mecanismo por baixo", "de cima"], cores=cs)
    exp = []
    for k, d in [("tras", (0, 60, 0)), ("frente", (0, -60, 0)), ("tampa", (0, 0, 120)), ("portinha", (0, 0, 160)),
                 ("prateleira", (0, 0, 40)), ("disco", (0, 0, 80)), ("calha", (0, -30, -10))]:
        m = pecas[k].copy(); m.apply_translation(d); exp.append(m)
    render.renderizar(exp, pasta / "explodida.png", vistas=("iso",), titulos=["vista explodida"],
                      cores=["#7fa7d9", "#e0a96d", "#9fd39a", "#f2c879", "#e6d36f", "#d98fb5", "#c9c9c9"])
    div = [pecas["tras_baixo"], pecas["tras_cima"], pecas["frente_baixo"], pecas["frente_cima"]]
    exp_div = []
    for m, d in zip(div, [(0, 30, 0), (0, 30, 40), (0, -30, 0), (0, -30, 40)]):
        c = m.copy(); c.apply_translation(d); exp_div.append(c)
    render.renderizar(exp_div, pasta / "versao_dividida.png", vistas=("iso",), titulos=["corpo dividido em 4"])
    cortes_folgas(pecas, pasta / "cortes_folgas.png")


def cortes_folgas(pecas, saida):
    """Cortes 2D ampliados das folgas: junta, tampa e saída do disco."""
    import matplotlib
    matplotlib.use("Agg")
    import matplotlib.pyplot as plt

    def desenha(ax, geo, cor):
        for g in getattr(geo, "geoms", [geo]):
            if g.is_empty or g.geom_type != "Polygon":
                continue
            ax.fill(*g.exterior.xy, color=cor, alpha=0.65, lw=0.5, ec="k")
            for i in g.interiors:
                ax.fill(*i.xy, color="white", lw=0.5, ec="k")

    fig, axs = plt.subplots(1, 3, figsize=(16, 5.2))
    for n, c in [("tras", "#7fa7d9"), ("frente", "#e0a96d")]:
        desenha(axs[0], cad.secao(pecas[n], "z", 150).intersection(box(-1, 85, 15, 115)), c)
    axs[0].set_title("Junta das metades (corte Z=150)")
    for n, c in [("frente", "#e0a96d"), ("tampa", "#9fd39a")]:
        desenha(axs[1], cad.secao(pecas[n], "x", 30).intersection(box(-12, 262, 18, 302)), c)
    axs[1].set_title("Tampa sobre a frente (corte X=30)")
    for n, c in [("prateleira", "#e6d36f"), ("disco", "#e0a96d"), ("paleta", "#d98fb5")]:
        if n in pecas:
            desenha(axs[2], cad.secao(pecas[n], "x", 100).intersection(box(15, 110, 110, 152)), c)
    axs[2].set_title("Saída e disco (corte X=100)")
    for ax in axs:
        ax.set_aspect("equal"); ax.grid(alpha=0.3); ax.set_xlabel("mm"); ax.set_ylabel("mm")
    plt.tight_layout(); plt.savefig(saida, dpi=100); plt.close(fig)


def construir(P=PARAMETROS):
    casca, info_c = carcaca(P)
    mec, fant, info_m = mecanismo(P, casca)
    pecas = {**casca, **mec}
    for lado in ("tras", "frente"):
        pecas[f"{lado}_baixo"], pecas[f"{lado}_cima"] = dividir(pecas[lado], P)
    return pecas, fant, {**info_c, **info_m}


if __name__ == "__main__":
    pecas, fant, info = construir()
    print(f"Parede de trás na entrada de energia: {info['entrada_espessura']:.1f} mm")
    ok = verificar(pecas, fant, info, PARAMETROS)
    saida = salvar(pecas, PARAMETROS)
    previas(pecas, fant, PARAMETROS, saida / "previas")
    print(f"Arquivos em {saida}")
    sys.exit(0 if ok else 1)
