Carriscar1/Iasis-app/(commit log)

2026-06-24 modelo inicial para o projeto
2026-06-28 feature: confirmação de email e integração com vercel
2026-06-28 feature: leitura das variáveis de ambiente no Vercel
2026-06-30 fix: buttons & functions
2026-07-12 feat: reforma v2.0 — tratamentos recorrentes, simulador ESP32 e fluxo fechado
    Funcionalidades
    - Agenda: tratamentos recorrentes (varios horarios/dia + duracao), navegacao
    por dia e aba "Meus remedios" (editar/excluir preservando historico)
    - Dispenser: simulador fiel do ESP32 (sensores, RFID, motor) em modo demo
    automatico; canal unificado com o MQTT real via src/config/app.ts
    - Fluxo de seguranca fechado executavel/visivel: alerta -> vibracao -> RFID
    valida (validated_by=rfid) -> DISPENSE -> vibracao cessa -> app confirma
    - Home: streak de adesao; Historico: exportar relatorio (PDF web / Share app)
    - Notificacoes: lembretes em lote + aviso de atraso (+10min)
    Correcoes
    - Sessao pers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
2026-08-28 feat: graficos de adesao, chat com cuidador (app + WhatsApp) e MQTT configuravel
    Graficos de adesao (nova tela /reports)
    - Componentes SVG: anel de percentual, barras por dia, barras de taxa
    - getAdherenceInsights: adesao por horario e por dia da semana
    - Insight do horario mais esquecido + exportar relatorio
    Chat paciente <-> cuidador
    - Servico de mensagens no Supabase com tempo real (postgres_changes)
    - Tela de conversa + lista de contatos; atalho para o WhatsApp
    - Telefone no perfil: no cadastro e em /edit-phone
    MQTT pronto para o hardware
    - Credenciais salvas no aparelho (AsyncStorage) via tela /dispenser-setup
    - Teste de conexao antes de salvar; troca demo <-> real sem editar codigo
    -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
2026-08-28 feat: alerta automatico para o cuidador quando o paciente perde uma dose
    Deteccao no banco (supabase_update4.sql)
    - Tabela public.alerts com RLS (le/marca/apaga apenas o proprio)
    - Gatilho doses_missed_alert: ao entrar em 'missed', cria o alerta para o
    cuidador vinculado, com nome do paciente, medicamento e horario
    - Indice unico parcial (dose_id, type) + ON CONFLICT com o predicado:
    sem ele o UPDATE de status falhava por inteiro (bug pego em teste)
    - RPC sync_overdue_doses(): marca vencidas do proprio usuario E dos
    pacientes vinculados, contornando a RLS de escrita do cuidador
    App
    - services/alerts.ts: listar, contar nao lidos, marcar, apagar, Realtime
    - hooks/useAlerts.ts: sincroniz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
2026-08-29 feat: estoque de medicamentos, modo facil, cuidador confirma dose e badge de mensagens
    Controle de estoque (supabase_update5.sql)
    - medications.stock / stock_threshold / units_per_dose
    - Gatilho doses_consume_stock: dose validada desconta do estoque e, ao
    cruzar o limite, cria alerta 'low_stock' para o paciente E o cuidador
    - RPC restock_medication: repoe e limpa o aviso; valida o dono
    - Tela /stock: estoque por remedio, estimativa de dias, repor com atalhos
    - Corrigido antes de aplicar: indice criado antes da coluna medication_id
    Modo facil (acessibilidade)
    - preferences.ts: preferencia salva no aparelho, carregada no arranque
    - hook useElderlyMode(): perfil paciente OU preferencia ligad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
2026-08-30 feat: home com secao de atencao, relatorio PDF com graficos e renovar tratamento
    Home reformulada
    - Secao "precisa de atencao" no topo: alertas nao lidos + remedios acabando,
    cada um levando direto para a tela correspondente
    - Estoque baixo e carregado para qualquer papel (inclusive cuidador)
    - Atalhos por papel agora incluem Estoque e Alertas
    Relatorio exportavel com graficos
    - Anel de adesao em SVG puro (imprime nitido, sem depender de imagem)
    - Nova secao "adesao por horario" com barras e a observacao do horario
    menos seguido; o card de resumo passa a mostrar o total de doses
    - ReportsScreen envia os insights para o relatorio
    Renovar tratamento
    - renewTreatment(): infere os horarios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
2026-08-30 feat: comparacao com o periodo anterior e relatorio pronto para impressao
    - getAdherenceTrend(): compara os ultimos N dias com os N anteriores usando
    apenas doses ja avaliadas (pendentes futuras distorceriam a conta)
    - Card de tendencia nos Relatorios com seta, delta em pontos e o tamanho da
    amostra dos dois periodos
    - Relatorio HTML agora fixa fundo branco (html/body + @media print): sem isso
    ele herdava o tema escuro do navegador e saia ilegivel no PDF
    - buildHtmlReport exportado para permitir verificacao automatizada do HTML
    Verificado gerando o relatorio com dados de exemplo: 44/44 divs, 1/1 svg,
    todas as secoes presentes, sem 'undefined'/'NaN', e conferido visualmente.
2026-09-08 feat: foto de perfil e cadastro de remedio por codigo de barras
    Foto de perfil pela camera ou galeria, reduzida para 256x256 no proprio
    aparelho e guardada junto com o perfil. Sem foto, o avatar mostra as
    iniciais numa cor estavel derivada do nome.
    Leitor de codigo de barras EAN-13/EAN-8 na caixa do remedio: o codigo
    lido preenche o cadastro sozinho. Codigo desconhecido vira um cadastro
    rapido que fica salvo numa base compartilhada, entao a proxima leitura
    da mesma caixa ja vem reconhecida. O digito verificador e conferido no
    app e no banco para nao gravar leitura ruim.
    Tratamento de permissao separa negada de negada definitivamente: quando
    o usuario marca "nao perguntar novamente" o siste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
2026-09-09 feat: equipe de cuidado com varios cuidadores por paciente
    Um paciente passa a ter quantos cuidadores precisar (filho, filha,
    enfermeira) em vez de um so. Todos recebem os mesmos avisos de dose
    perdida, estoque acabando e emergencia.
    O cuidador e escolhido na agenda do celular, o que evita digitar telefone
    errado -- e telefone errado aqui significa alerta indo para um
    desconhecido. A tela de contatos foi feita para agenda grande de verdade:
    leitura paginada com rolagem infinita, busca por nome resolvida pela
    consulta nativa do sistema (nao filtrando array em memoria) e FlatList
    pura com altura de linha fixa, para as views serem recicladas em vez de
    acumularem. Quem ainda nao usa o app receb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
2026-09-09 feat: emergencia com localizacao e deteccao de queda
    Botao de socorro que avisa toda a equipe de cuidado de uma vez, com a
    posicao e -- o que importa tanto quanto -- a precisao dela. O indicador
    mostra verde abaixo de 10 m, amarelo entre 10 e 30 m e vermelho acima
    disso: quem vai socorrer precisa saber se o ponto aponta a casa ou o
    quarteirao antes de sair de carro. Sem GPS o aviso sai do mesmo jeito,
    porque um alerta sem coordenada ainda vale muito mais que nenhum.
    Deteccao de queda pelo acelerometro: a magnitude do vetor
    |a| = raiz(x^2+y^2+z^2) passando de 2,0 g abre uma contagem de 30
    segundos. Caminhar fica em torno de 1,2 g e sentar com forca bate 1,6 g,
    entao o limite separa impacto d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
2026-09-09 feat: historico disponivel sem internet e exportacao em planilha
    O historico de adesao passa a funcionar offline: toda leitura bem
    sucedida grava uma copia no aparelho e, quando a rede falha, a tela
    mostra essa copia com a data de quando foi tirada em vez de ficar vazia.
    A faixa no topo diz "salvo ha 20 min" para ninguem decidir com dado
    velho achando que e o de agora. Isso importa porque o momento em que o
    historico mais serve -- a consulta medica -- costuma ser onde o sinal e
    pior.
    A deteccao de offline vem do proprio resultado da consulta, nao de um
    detector de conectividade: Wi-Fi conectado sem saida para a internet
    aparece como online e mentiria.
    Exportacao das doses em CSV, ao lado d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
2026-09-09 fix: layout correto com o aparelho deitado
    As telas usavam area segura so no topo, entao em celular com notch o
    conteudo passava por baixo do recorte lateral quando deitado. Agora as
    28 telas reservam tambem as laterais.
    A tela de sair e o aviso de queda ganharam rolagem: os dois sao cartoes
    altos que nao cabem inteiros num celular deitado, e antes o botao de
    confirmar ficava fora do alcance.
    README atualizado com a versao 3.0 e com a tabela de como cada recurso
    se comporta quando falta hardware ou permissao.
2026-09-09 feat: tema claro e escuro em todo o aplicativo
    Escolha entre claro, escuro ou seguir o aparelho, em Perfil > Aparencia.
    A troca vale na hora, sem reiniciar.
    StyleSheet.create congela as cores no momento em que roda, entao nao
    adianta trocar os valores de um objeto global -- as folhas de estilo ja
    nasceram com a cor antiga. Cada tela passou a declarar seus estilos como
    funcao da paleta (makeStyles) e o hook useTheme resolve qual paleta usar,
    com cache por tema para nao recriar folha a cada render.
    O escuro nao e o claro invertido. Um detalhe que exigiu separar tokens:
    `navy` era usado tanto como FUNDO de cabecalho e botao (texto branco por
    cima) quanto como COR de icone e texto. No claro os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
2026-10-04 feat: valida o formato do e-mail antes de enviar o formulario
    O erro de digitacao no e-mail aparecia tarde: no login virava "credenciais
    invalidas" e no cadastro a pessoa ficava esperando um e-mail de confirmacao
    que nunca chegava. Agora a tela avisa na hora, com um exemplo do formato.
    A regex e frouxa de proposito (algo@algo.sufixo). Recusar endereco valido
    por regex restritiva e pior que deixar passar um endereco inexistente, que
    o e-mail de confirmacao resolve de qualquer forma.
2026-10-19 feat: skill de modelagem 3D das pecas do dispensador
    Biblioteca e roteiro para inspecionar, alterar e conferir os STL do
    dispensador por codigo: referencial unico em mm, booleanas robustas,
    arredondamento de casca, encaixe macho-femea, aba de tampa, logo em
    relevo, cortes 2D e previas renderizadas sem GPU.
    Claude-Session: https://claude.ai/code/session_01SynPnpTcJTe3DotFZiqP4h
2026-10-19 feat: carcaca do dispensador com encaixes, entrada de energia e logo
    As duas metades do corpo agora encaixam por macho e femea, a tampa tem
    uma aba que entra na boca do corpo, a parede de tras ganhou a entrada
    de energia, a frente ficou arredondada e leva a logo do coracao com ECG.
    Os STL saem em mm a partir dos originais e de um script com parametros.
    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
2026-10-20 feat: dispensador completo pronto para imprimir
    O modelo agora tem o mecanismo inteiro: prateleira que entra por cima e
    assenta num apoio a 45 graus, disco de 8 compartimentos no eixo do
    NEMA 17, trava com paleta no servo SG90 e calha que leva a dose ate a
    bandeja. A carcaca ganhou pinos para o LCD, trilhos para o RC522 atras
    do coracao, paineis para a eletronica e quatro parafusos na tampa.
    Os STL saem ja deitados na posicao de impressao, em versao inteira e
    dividida em 4 para impressoras de 220 mm, com corpos de prova para
    testar cada encaixe antes das pecas grandes. A verificacao confere
    malha fechada, sobreposicao zero entre pecas e componentes, giro da
    trava e passagem pela abertura de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
2026-10-20 feat: pacote para grafica 3D com lista de pecas e estimativa de filamento
    O empacotar.py junta os STL das duas versoes, os corpos de prova e as
    imagens num zip com um LEIA-ME para a grafica: qual pasta usar conforme
    a impressora, configuracao de impressao, quantidade e filamento por peca.
    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
2026-10-20 feat: versao rapida do dispensador para imprimir a tempo da feira
    O corpo ficou oco por dentro (o enchimento macico dos modelos originais
    nao tinha funcao depois da calha), a tampa passou de 20 para 5 mm e o
    disco de 20 para 16 mm. O filamento caiu de ~1,75 kg para ~1 kg. As
    folgas ficaram um pouco maiores para impressao em rascunho sem corpo de
    prova, e o pacote da grafica traz perfil rapido, ordem de prioridade e
    estimativa de tempo.
    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
2026-10-20 feat: clipes 3D do dispensador para o video do stand
    Renderizador por software com perspectiva, iluminacao e contornos
    (z-buffer compilado com numba) e cinco cenas em 1920x1080: o dispensador
    girando, a vista explodida, peca por peca com destaque e legenda, o
    fluxo da dose do alarme ate a bandeja e o encerramento. Cada clipe sai
    com e sem legenda, e todos juntos formam o video de 2 minutos.
    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
2026-10-20 feat: dispensador roxo no video, na cor do filamento da equipe
    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
2026-10-20 feat: video do stand em tons de bege com mascote 3D narrador
    Mascote Iasinho modelado em 3D (coracao com asas, olhos, bracos que apontam
    para a peca da cena), titulos de cena para o publico, legenda da narracao,
    efeito de explosao ao desmontar a caixa e geracao do roteiro do locutor.
    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
2026-10-20 fix: renderizacao do video retoma de onde parou
    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
2026-10-20 fix: camera mostra a frente do dispensador enquanto a narracao fala dela
    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
2026-10-20 feat: video 3D em loop para o monitor e narracao mais rapida e animada
    - gerar_loop.py: dispensador desmonta, mostra peca por peca com destaque e
    monta de novo em 72 s que emendam sem pulo; o Iasinho sobrevoa so olhando
    - mascote3d: parametro olha (vira corpo e olhos sem apontar) e periodos
    que dividem 72 s
    - narrar.py: --acelerar (video e legenda juntos) e --animado (entonacao
    de locutor)
    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
2026-10-21 feat: apresentacao em slides com uma animacao por fase do video
    gerar_video_v2.py ganha o modo IASIS_LIMPO (sem legenda nem titulo) e
    gerar_slides.py corta um clipe por fase e monta o PowerPoint com o clipe,
    os topicos e a fala do mascote nas notas do apresentador.
    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
2026-10-21 feat: QR code de votacao no video em loop do stand
    Cartao com QR nas cores do video e o coracao da logo no meio, fixo no canto
    inferior esquerdo do loop. O script confere a leitura do QR antes de salvar.
    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
2026-10-21 feat: tela de intervalo "Voltamos em breve" em loop com o Iasinho
    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
2026-10-21 feat: dose cai sozinha no dispensador e tampa ganha portinha de abastecer
    Disco com 7 bolsos de 30 mm (cabe bala e bala de goma), mais largos
    embaixo, girando 0,8 mm acima da prateleira sem arrastar; saída de 34 mm,
    calha a 50° e posição de descanso para nada cair antes da hora. A tampa
    ganhou uma portinha cônica de 120 x 120 mm para abastecer sem parafusos.
    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
2026-10-23 feat: pacote de impressão pronto para a Bambu Lab A1
    Só as peças que cabem no volume de 256 mm, numeradas por mesa, com a
    configuração de PLA e a conferência de que cada mesa cabe na impressora.
    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
2026-10-23 chore: zip de impressão para a A1 disponível para baixar pelo celular
    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
2026-11-04 feat: calha firme no fundo e guia visual de montagem
    A calha ganhou pés para colar no fundo e uma lingueta que atravessa a
    janela até a bandeja, então não tomba nem sai do lugar. Um guia legendado
    mostra onde vai cada peça e o que entra em cada furo.
    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
2026-11-05 feat: chaveiro com a logo do IASIS e tag NFC escondida dentro
    Coração de 50 mm com o ECG em relevo; a tag entra num bolso fechado
    durante uma pausa da impressão, ou entre duas metades coladas.
    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
2026-11-05 feat: trava com servo volta, agora como portinha no fim da calha
    A dose desce a rampa e espera atrás de uma portinha que o SG90 abre depois
    da pulseira. O servo fica preso na própria calha, longe do motor, e nada
    fica preso entre o disco e a prateleira.
    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
2026-11-10 feat: trava do servo volta para baixo da saída, como no vídeo
    A paleta tampa a saída logo abaixo da prateleira já impressa e abre girando
    80° para a direita, contornando o motor. O suporte do SG90 é colado por
    baixo da prateleira na posição dada por um gabarito; a portinha da calha
    sai.
    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
2026-11-10 chore: kit da trava (peças, firmware e passo a passo) para baixar pelo celular
    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
2026-11-11 feat: manual de montagem com fiação pino a pino e vídeo passo a passo
    Gera o diagrama de fiação, um vídeo com cada peça entrando no lugar na
    ordem certa e um PDF com lista de materiais, passos, tabelas de ligação,
    firmware e checklist antes de ligar.
    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
2026-11-11 chore: manual de montagem (PDF, vídeo e fiação) para baixar pelo celular
    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
